qilinxiaoxiang/cmu-microduck/3-brain-and-senses/camera/CAMERA.md

# MicroDuck head camera stream (measured 2026-10-16, Pi Zero W, Camera Module 3 Wide)

- Pi side: `duck-cam.service` runs `pi/duck_cam.sh` (rpicam-vid, H.264 baseline 640x480 10 fps, TCP listener). Start/stop: `ssh duck sudo systemctl start|stop duck-cam.service`; disable on boot: `sudo systemctl disable --now duck-cam.service`; logs: `journalctl -u duck-cam.service -f`. A client disconnect ends rpicam-vid (SIGABRT "failed to send data on socket"); systemd restarts it within ~1 s. One client at a time.
- Stream URL: `tcp://<head-computer>:8554` (raw H.264 Annex B, SPS/PPS every 10th frame). Mac: `from duck_cam import DuckCam; cam = DuckCam().start(); frame, t_arrival, idx = cam.latest()`. CLI: `~/.venvs/microduck-walk/bin/python duck_cam.py --seconds 60 --save DIR --arrivals a.txt`.
- Sensor mode in use: 2304x1296 (full sensor, 2x2 binned; journal line "Selected sensor format: 2304x1296"). The 640x480 output is ScalerCrop (576,0)/3456x2592: full sensor height, centre 75 % of the width. FOV about 86 deg horizontal x 67 deg vertical (rectilinear estimate from the 102 x 67 deg full-sensor spec). `--no-raw` must stay out of the command: it overrides `--mode` and the sensor falls back to the cropped 1536x864 mode (2/3 FOV).
- Flicker: `--flicker-period 8333` (60 Hz mains) removed the pink/green banding seen in the uncorrected still; exposure then locks at 8310 us (metadata readback).
- Measured on the Mac over Tailscale (direct LAN path, `tailscale ping` 16 ms; Pi Wi-Fi power save already off, -52 dBm, TX 26 Mbit/s): open 1.55-2.07 s, first frame 3.1-4.5 s after `start()`. Clean 60 s run (no other ssh/CPU load): 599 frames, 9.99 fps, gap mean 100 ms, max 230 ms. Backlog probe (pause reader 1 s, drain): 9 frames drained in 92 ms vs 10 expected, i.e. about 0 frames in flight at steady state; decode on the Mac keeps up.
- Stalls under contention: a 40 s run while `top` was polled over ssh on the Pi fell to 8.1 fps with a 5.4 s gap; the first 60 s run (Mac busy with other scripts) had 14 gaps >200 ms, max 1.13 s. The IMU stream did not stall at those moments. A controller must use `t_arrival` and treat frames older than ~0.3 s as missing rather than acting on them.
- IMU impact (walk_wired log /tmp/duck_wired_log_1016y.jsonl, 60 s windows, mode stand): baseline p50 11.3 / p95 30.1 / max 68.5 ms, 0.87 % over 40 ms; streaming p50 11.7 / p95 27.8 / max 59.3 ms, 0.64 % over 40 ms. Pi CPU while streaming: rpicam-vid 11-18 %, IMU reader 24-35 % (top samples).
- MJPEG alternative (`DUCK_CAM_CODEC=mjpeg`): first frame 1.49 s (faster) but 7.3 fps and more bandwidth; backlog also ~0. H.264 kept.
- Orange detector (`orange_target.py`, HSV 5-22 / 120-255 / 120-255, open 5x5, largest component): 57/57 stream frames hit the orange printed part at cx 52.5 +/- 0.22 px, cy 459.3 +/- 0.09 px, area ~3074 px. Scene HSV (percentile 5/50/95): orange part H 7/10, S 236, V 150; red box label H 1-6, S 109 (mostly rejected); cardboard H 16-18, S 136-154, V 70-85 (rejected only by V < 120, the main false-positive risk under brighter light); white desk S ~20; grey floor H 30-50, S < 30.
- Known gaps: no clock-aligned end-to-end latency figure (Pi and Mac clocks differ; only backlog and first-frame times measured); one client only; stalls under Wi-Fi/CPU contention are not yet characterised with a dedicated test; the detector keys on a colour range, not an object model, so other saturated orange/red surfaces will be picked up.
