qilinxiaoxiang/cmu-microduck/2-servos-openrb/scripts/servo_ids.png

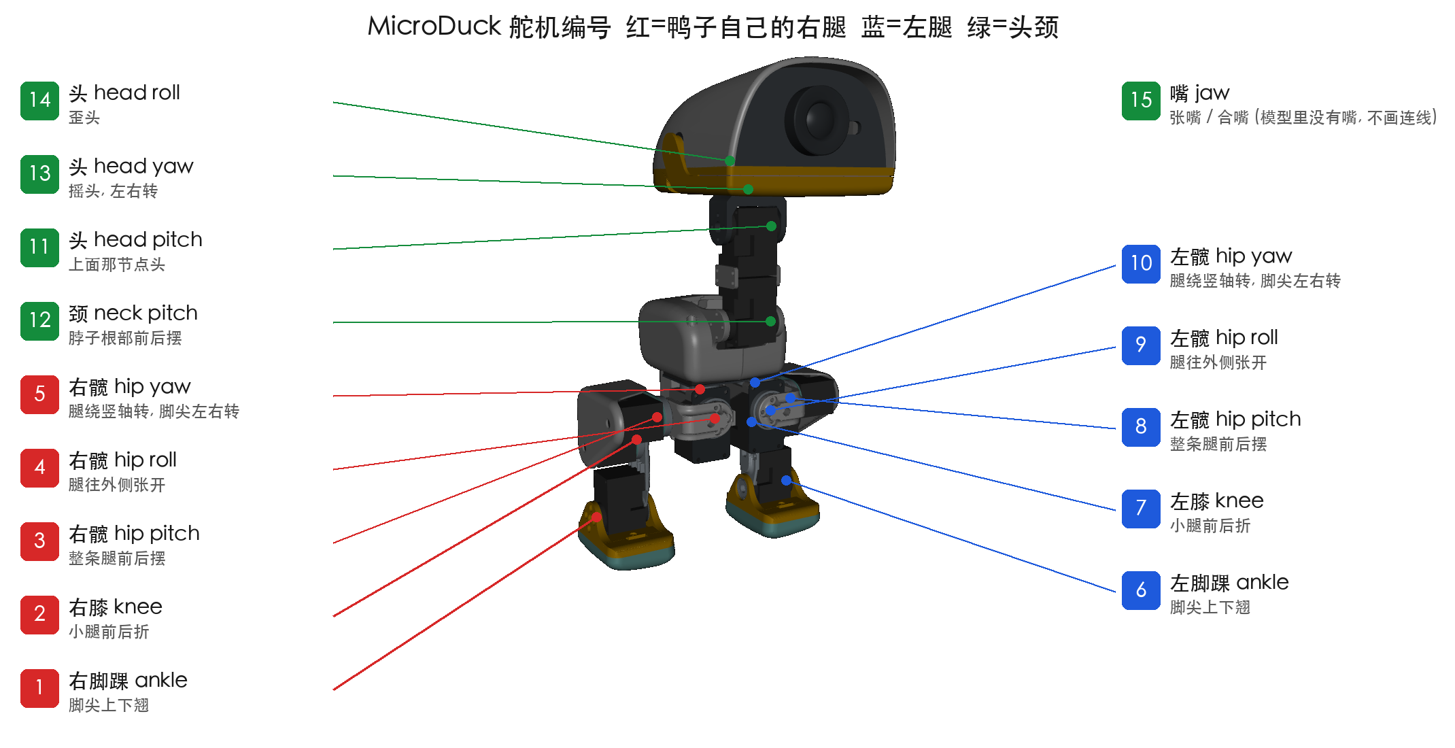
2-servos-openrb/scripts/servo_ids.png
