qilinxiaoxiang/cmu-microduck/3-brain-and-senses/touch/touch_layout.png

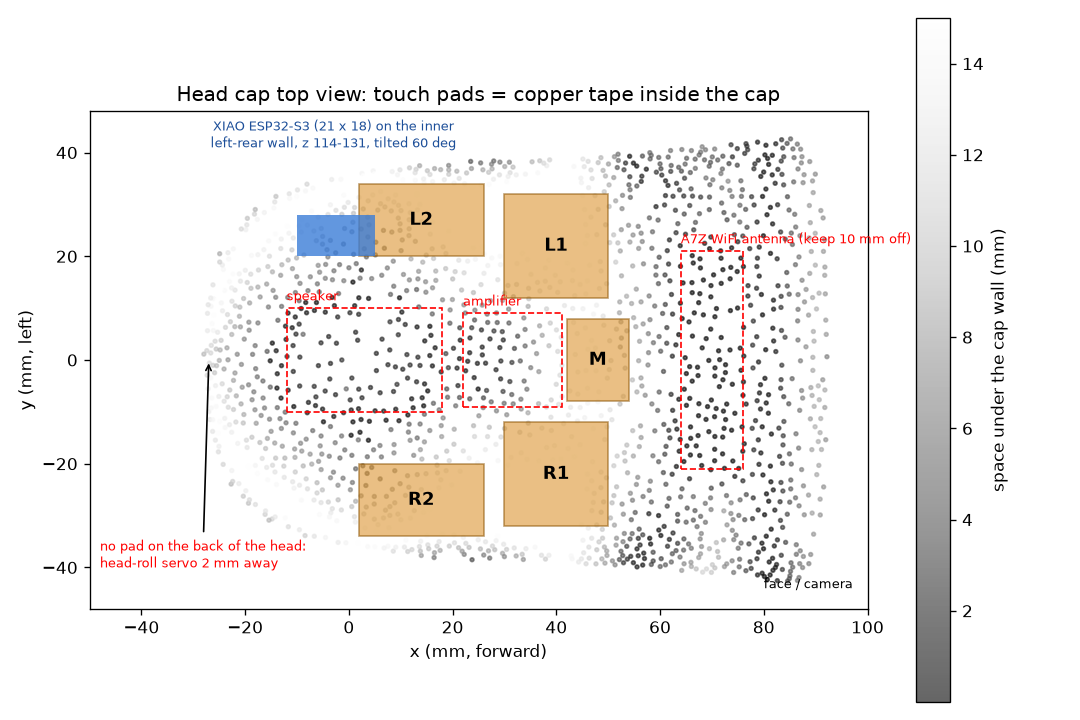
3-brain-and-senses/touch/touch_layout.png
