qilinxiaoxiang/cmu-microduck/4-power/images/amass_mr30_pair.jpg

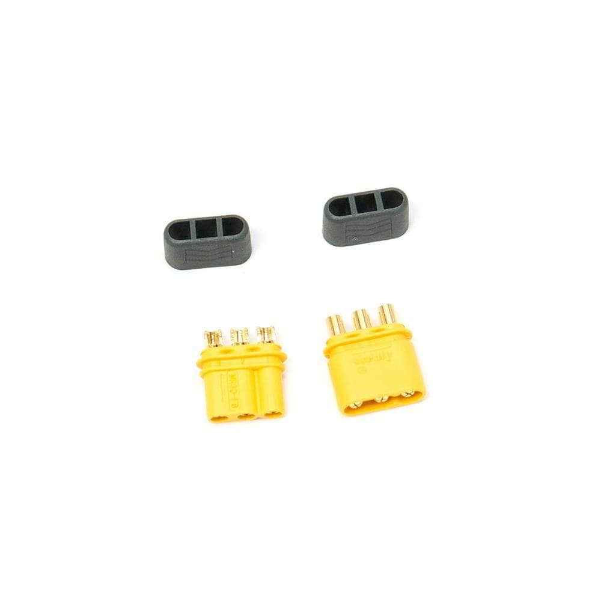
4-power/images/amass_mr30_pair.jpg
