qilinxiaoxiang/cmu-microduck/4-power/images/dfr1202_top.jpg

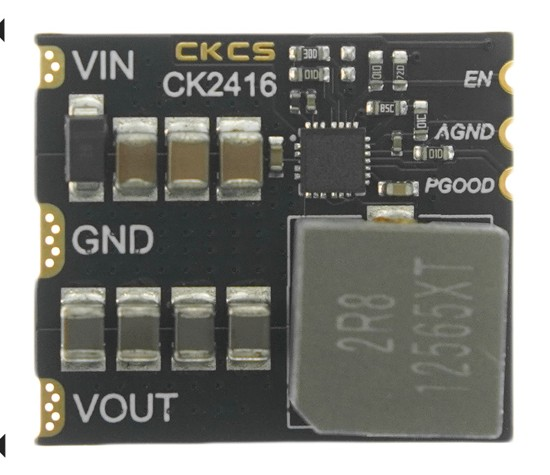
4-power/images/dfr1202_top.jpg
