qilinxiaoxiang/cmu-microduck/4-power/images/openrb_150_top.png

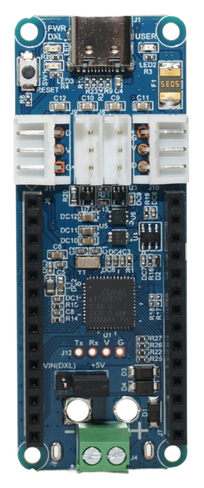
4-power/images/openrb_150_top.png
