qilinxiaoxiang/cmu-microduck/4-power/images/pd5991_board.jpg

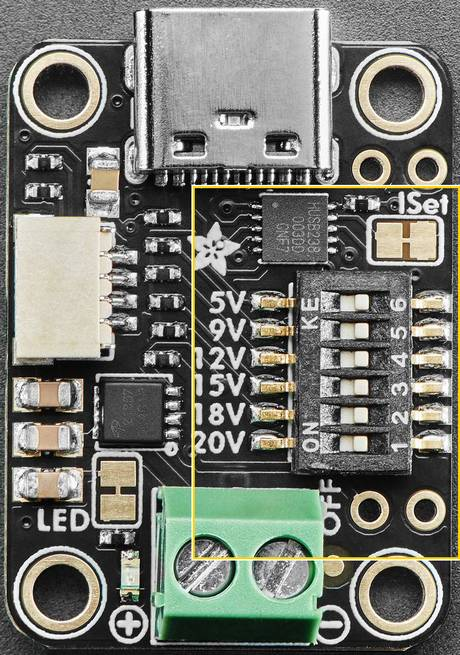
4-power/images/pd5991_board.jpg
