qilinxiaoxiang/cmu-microduck/4-power/images/pd5991_dip.jpg

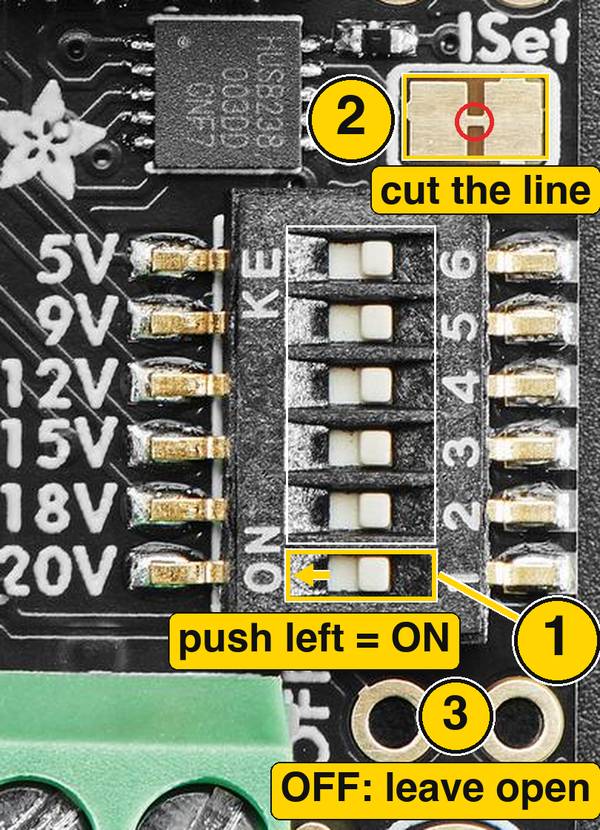
4-power/images/pd5991_dip.jpg
