qilinxiaoxiang/cmu-microduck/4-power/images/power-web.jpg

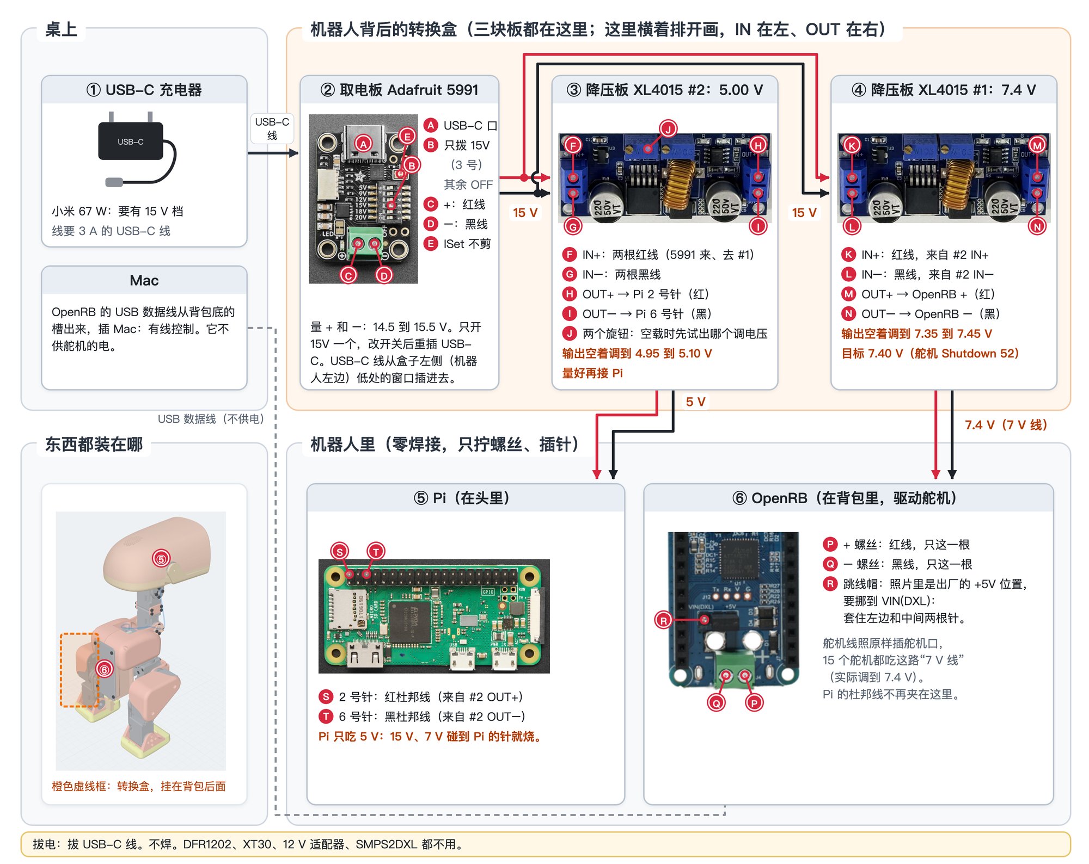
4-power/images/power-web.jpg
