qilinxiaoxiang/cmu-microduck/4-power/images/rev_31_1387.png

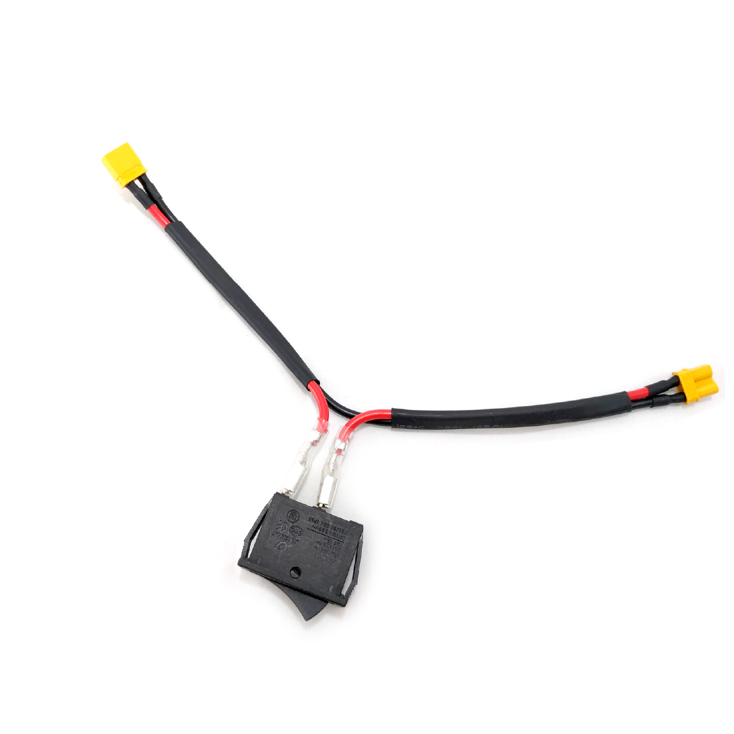
4-power/images/rev_31_1387.png
