qilinxiaoxiang/cmu-microduck/4-power/images/swann39_side.jpg

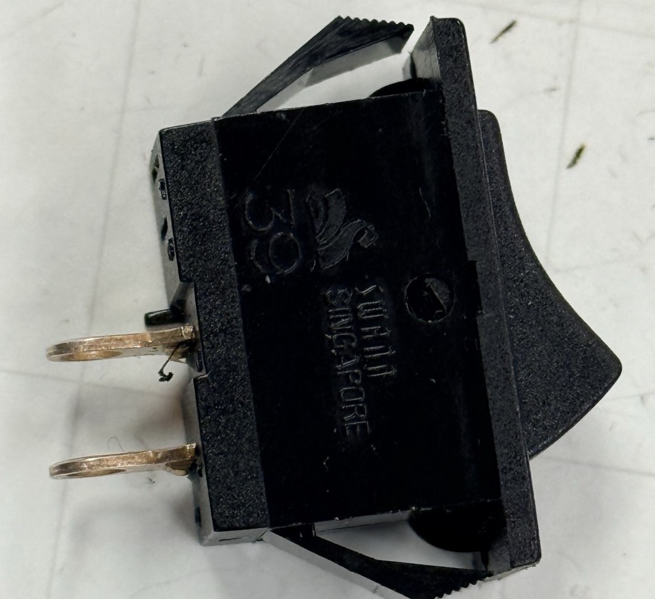
4-power/images/swann39_side.jpg
