qilinxiaoxiang/cmu-microduck/4-power/images/tattu_2s650_xt30.jpg

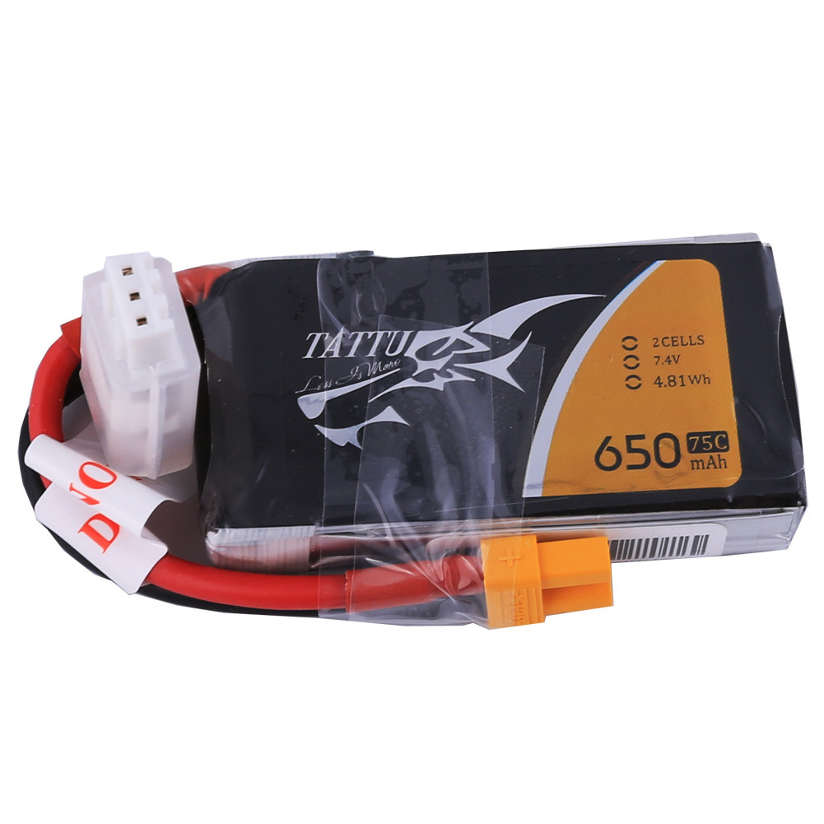
4-power/images/tattu_2s650_xt30.jpg
