qilinxiaoxiang/cmu-microduck/4-power/images/usb_pd_5991_top.jpg

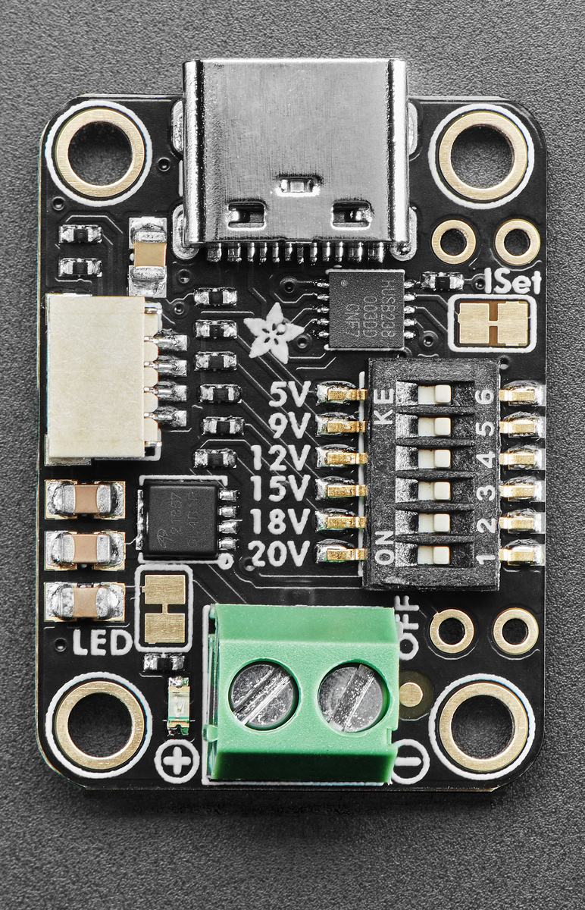
4-power/images/usb_pd_5991_top.jpg
