qilinxiaoxiang/cmu-microduck/4-power/images/xl4015_board.jpg

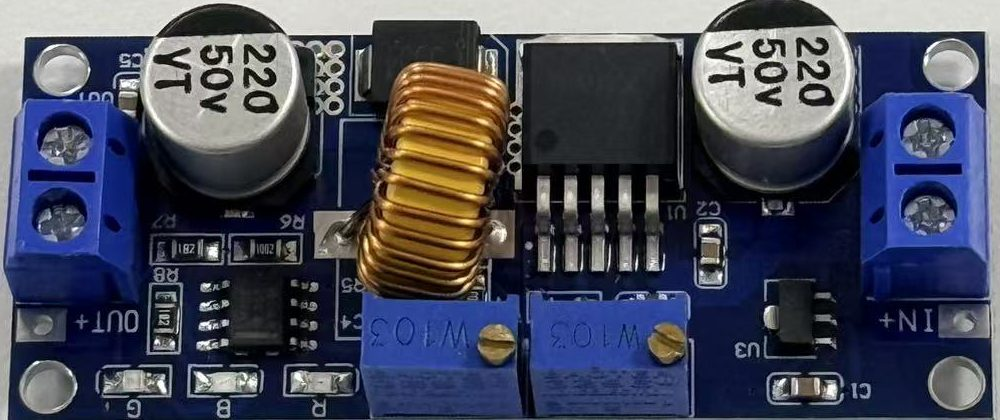
4-power/images/xl4015_board.jpg
