qilinxiaoxiang/cmu-microduck/4-power/images/xl4015_trimmers_annotated.png

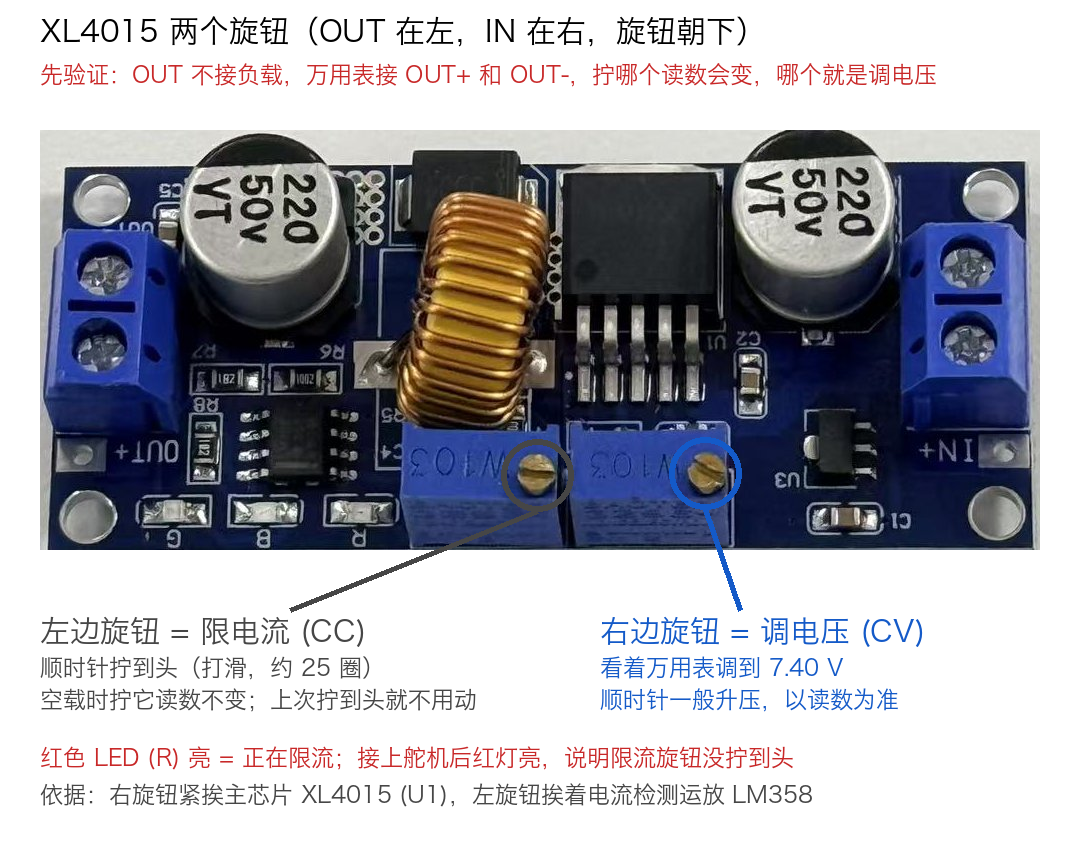
4-power/images/xl4015_trimmers_annotated.png
