qilinxiaoxiang/cmu-microduck/4-power/images/xt30_fit0586_rear.jpg

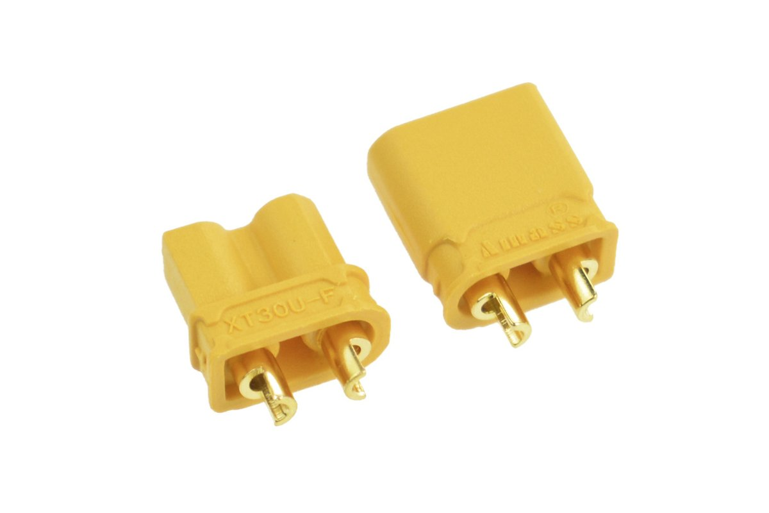
4-power/images/xt30_fit0586_rear.jpg
