qilinxiaoxiang/cmu-microduck/BOM.md

# Bill of materials, CMU MicroDuck foundation (2026-10-23)

Generated by `scripts/build_bom.py` from the project's procurement records (`bom.json`, `catalog-en.json`, `cart-plan.json`, `sourcing-policy.json`, prices as read on the dates recorded there, mostly September and October 2026) and `0-procurement/foundation-additions.json` for the parts bought after those records. Prices are what the records hold, not current quotes. Order numbers and receipts are not published. The sourcing policy of the project is kept: a part on hold or marked club supply was not bought, and this list does not ask you to buy it either; the CMU RoboClub drawers supplied screws, wire and consumables.

The role text of the club-drawer and tool rows is the September 2026 record and some of it describes the harness of that time (12 V, SMPS2DXL, Raspberry Pi); the part and quantity columns are what the robot uses. Printed parts are in `1-printing/`. Servo count, roles and IDs are in `2-servos-openrb/`.

## Bought or supplied for this robot and on it now

| Part | Qty | Store | Unit price | Link | Note |
|---|---|---|---|---|---|
| Radxa Cubie A7Z (Allwinner A733, 40-pin header) | 1 each | Amazon | not recorded |  | Head computer since 2026-10-17 (D-011). Ordered on Amazon 2026-10-15; the listing and price were not kept in the project records. Radxa product page: https://radxa.com/products/cubie/a7z |
| Adafruit 3006 MAX98357A I2S mono amplifier | 1 each | DigiKey | $5.95 | [link](https://www.digikey.com/en/products/detail/adafruit-industries-llc/3006/6058477) | Converts the Pi digital audio stream and drives the speaker. |
| Radxa AC019 dual-band FPC Wi-Fi antenna, IPEX gen 1, 42 x 11.9 mm | 1 each | with the A7Z | not recorded |  | Stuck under the front of the head cap crown (docs/A7Z-ANTENNA.html). |
| Discarded bicycle inner tube (butyl, about 1 mm) plus thin double-sided tape | 1 piece | free | included |  | Foot soles, cut with the template in the feet-sole study; the hot-glue mold route was dropped 2026-10-19. |
| ROBOTIS OpenRB-150 (included in OMX-AI) | 1 each | ROBOTIS US | $52.79 | [link](https://robotis.us/products/openrb-150-starter-kit) | One OpenRB-150 servo bus controller allocated from the two authorized OMX-AI kits. |
| Copper foil tape with conductive adhesive, 5 mm strips | 1 roll | Amazon | $5.95 |  | The five touch pads inside the head cap (L1, R1 18 mm; L2, R2, M 12 mm). Price from the touch plan (USD 5.95); listing not kept. |
| Adafruit BNO085 / 4754 | 1 each | DigiKey | $29.50 | [link](https://www.digikey.com/en/products/detail/adafruit-industries-llc/4754/13426653) | Measures body orientation from its fixed trunk mount. |
| Adafruit 4397 STEMMA QT/Qwiic JST-SH4 to female sockets, 150mm | 1 lead | DigiKey | $0.95 | [link](https://www.digikey.com/en/products/detail/adafruit-industries-llc/4397/10824270) | Connects to the Pi I2C bus. |
| ROBOTIS X3P180mm, JST EHR-3 / 21AWG | 15 lead | kit | included |  | Cut each in half to obtain 30 approximately 90mm tails. |
| ROBOTIS OMX-AI kit (two kits supply the 15 XL330-M288-T, the OpenRB-150, the X3P cables, the XL4015 modules and the TAP screws) | 2 kit | ROBOTIS US | not recorded | [link](https://robotis.us) | The servo and controller rows below are allocated from these kits; the kit price is not kept in the records. |
| Adafruit 5991 HUSB238 switchable USB PD receiver | 1 each | DigiKey | $9.95 | [link](https://www.digikey.com/en/products/detail/adafruit-industries-llc/5991/24892287) | Power route A: the HUSB238 decoy that asks the USB-C PD source for 20 V (D-007, D-014). The 'retired 2026-10-13' flag in the record is stale. |
| Four precrimped female 2.54mm leads, 22AWG, 250mm, fixed insulated housing | 4 each |  | not recorded |  | The two 5 V leads to A7Z header pins 2 and 6. |
| Radxa Camera 13M 214 (IMX214, 4-lane CSI) | 1 each | Amazon | not recorded |  | Eye camera on the A7Z CSI port, screwed to the V1.17 face panel bosses with four M2 x 4. Ordered on Amazon 2026-10-15; listing and price not kept. Radxa docs: https://docs.radxa.com/en/accessories/camera/camera-13m-214 |
| 32GB microSD; reuse or borrow a compatible card | 1 card | CanaKit | included | [link](https://www.canakit.com/raspberry-pi-zero-2-w.html?cid=usd) | The 16 GB microSD now carries the A7Z Debian image (3-brain-and-senses). |
| Adafruit5212 USB Type C microSD reader/writer | as needed each | Adafruit | $6.95 | [link](https://www.adafruit.com/product/5212) | Needed once to write the A7Z card. |
| ROBOTIS DYNAMIXEL XL330-M288-T / 902-0163-000 | 15 each | ROBOTIS US | $27.49 | [link](https://robotis.us/products/dynamixel-xl330-m288-t) | Fourteen walking/head-neck joints and the fifteenth servo for the jaw. |
| Same Sky CMS-30204-18SP, 8 ohm 1W oval speaker | 1 each | DigiKey | $1.34 | [link](https://www.digikey.com/en/products/detail/same-sky-formerly-cui-devices/CMS-30204-18SP/29778290) | The component that produces sound; neither Pi nor OpenRB includes this speaker. |
| Adafruit 4472 USB-A to USB-C data/sync cable, 6 inch | 1 lead | DigiKey | $2.95 | [link](https://www.digikey.com/en/products/detail/adafruit-industries-llc/4472/11587359) | Intact short data cable from the OTG adapter to OpenRB-150. |
| USB-C PD wall charger with a 20 V 5 A (100 W) PDO | 1 each | owned | not recorded |  | Power route A source. A 20 V 3 A (60 W) charger folds back at the walking current peaks and freezes the A7Z (2026-10-22). Model not recorded. |
| Seeed Studio XIAO ESP32-S3 | 1 each | Seeed Studio | $7.49 | [link](https://www.seeedstudio.com/XIAO-ESP32S3-p-5627.html) | Touch readout board in the head cap: five capacitive inputs, I2C slave at 0x2A to the A7Z (D-013). Price read 2026-10-15. |
| Xiaomi 212W HyperCharge Power Bank 25000 | 1 each | owned | not recorded | [link](https://www.mi.com/global/product/xiaomi-212w-hypercharge-power-bank-25000/) | Power route A source for untethered runs; the robot ran from it on 2026-10-23. |
| XL4015 CC/CV buck converter modules (two, from the ROBOTIS OMX-AI kits) | 2 each | ROBOTIS US (kit accessory) | included |  | #1 makes the servo rail, #2 the A7Z 5 V, both in the rear converter box (D-007). |

## Battery route (D-010): bought, backpack being built, not yet on the robot

| Part | Qty | Store | Unit price | Link | Note |
|---|---|---|---|---|---|
| Tattu 650 mAh 2S 7.4 V 75C LiPo, XT30 plug | 2 each | Amazon | $9.16 | [link](https://www.amazon.com/dp/B0727XZFDW) | Power route B (D-010). Bought 2026-10; backpack not yet on the robot. |
| Tenergy LiPo safety bag, medium 7 x 9 in | 1 each | Amazon | $8.99 | [link](https://www.amazon.com/dp/B08QCMMGJT) | Charging and storage bag for the two packs. |
| Amass MR30 male + female, 10 pairs | 1 pack | Amazon | $9.99 | [link](https://www.amazon.com/dp/B0747MW9RX) | The 5 V joint for the A7Z lead: a shape that cannot mate with the XT30 servo joint. |
| DFRobot FIT0586 XT30 male+female pair / DigiKey 1738-1436-ND | 1 pair | DigiKey | $1.90 | [link](https://www.digikey.com/en/products/detail/dfrobot/FIT0586/9559255) | XT30 pair: the robot's servo inlet for the battery backpack (D-010). |
| Swann 39 rocker switch (RoboClub drawer); D-010 planned the REV-31-1387 XT30 switch | 1 each | CMU RoboClub | not recorded |  | The V1.20 and V1.31 backpack frames carry the 12.3 x 27.5 mm cutout for the Swann 39 body. |
| DFRobot DFR1202, 6-24V input, 5V output | 1 each | DigiKey | $12.90 | [link](https://www.digikey.com/en/products/detail/dfrobot/DFR1202/27526972) | Power route B: makes 5 V for the A7Z inside the battery backpack (D-010). Bought; backpack not yet on the robot. |
| Amass XT30U male + female, 10 pairs with heat shrink | 1 pack | Amazon | $8.99 | [link](https://www.amazon.com/dp/B07CTRH86M) | Backpack feed lead (male) and servo lead (female); spares. |

## From the CMU RoboClub drawers (not bought; club supply)

| Part | Qty | Store | Unit price | Link | Note |
|---|---|---|---|---|---|
| Pyrodrone24AWG silicone wire,1m red+1m black | 0.25 m per color | Pyrodrone | $3.99 | [link](https://pyrodrone.com/products/1ft-silicone-wire-choose-color-and-gauge?variant=16927242911787) | Direct 24AWG power pair from the 0.5A fuse/common ground to amplifier VIN/GND. |
| Pyrodrone 20AWG Silicone Wire, 1m red + 1m black/set | 2.0 m per color | Pyrodrone | $5.99 | [link](https://pyrodrone.com/products/1ft-silicone-wire-choose-color-and-gauge?variant=16927272861739) | Eight motor group feeds, each250mm per color including20mm before the fuse. |
| Heat shrink for the two splices and the DATA wire end, three small cable ties, 12V polarity label | as needed set |  | not recorded |  | Insulates the SMPS2DXL cable splices and keeps tether pull off the solder joints and the SMPS2DXL plug. |
| Bambu PLA Basic Jade White 10100, 1.75mm, 1kg WITH SPOOL | as needed g | Bambu Lab US | $22.99 per pack of 1000 | [link](https://us.store.bambulab.com/products/pla-basic-filament) | Prints the original duck and all revised components. |
| Adafruit 3468 electronics flux | as needed each | Adafruit | $7.95 | [link](https://www.adafruit.com/product/3468) | Assists wire and small-pad wetting. |
| 3M (TC) 4492W-0.5-5 / 1067-4492W-0.5-5-ND, 1/2 inch × 5 yards, 0.787mm nominal | as needed roll | DigiKey | $11.93 | [link](https://www.digikey.com/en/products/detail/3m-tc/4492W-0-5-5/2649500) | Audio support height adjustment and battery cushioning. |
| Adafruit 4559 heat-shrink assortment | as needed set | Adafruit | $9.95 | [link](https://www.adafruit.com/product/4559) | Separately insulates fuses and main/data solder joints. |
| M2.6x6 TAP; manufacturer-matched rear-center screw; ROBOTIS BHS rounded head profile, diameter5.5mm height1.565mm | 8 screw | ROBOTIS US | $11.27 per pack of 8 | [link](https://www.robotis.us/fpx330-h101-4pcs-set/) | Six integral rear supports plus two standalone idler/cap assemblies at IDs11 and12. |
| Adafruit 3057 polyimide tape | as needed roll | Adafruit | $4.95 | [link](https://www.adafruit.com/product/3057) | Insulates bare connectors; cannot substitute for structural ties. |
| M2-0.4x10mm pan-head screw; head <=4mm diameter x1.72mm height | 4 each |  | not recorded |  | Camera PCB to cradle; full M2 nut engagement and 1.73mm tip extension. |
| M2-0.4×12mm A2 Phillips pan, DIN7985A/ISO7045 | as needed each | Monster Bolts | $1.14 per pack of 10 | [link](https://monsterbolts.com/products/mach-phil-pan-a2-m2?variant=38436355020) | Unused old small-regulator cover; no small regulator in current design. Cover screws interfere with retained motors. |
| M2-0.4×18mm A2 Phillips pan, DIN7985A/ISO7045 | 4 each | Monster Bolts | $1.46 per pack of 10 | [link](https://monsterbolts.com/products/mach-phil-pan-a2-m2?variant=38436768844) | Four OpenRB standoffs. |
| M2-0.4×20mm A2 Phillips pan, DIN7985A/ISO7045 | 4 each | Monster Bolts | $1.37 per pack of 10 | [link](https://monsterbolts.com/products/mach-phil-pan-a2-m2?variant=38436355596) | Four fuse-carrier screws through11.5mm carrier posts and4mm shelf/boss stack, without old regulator PCB; retain four nuts. |
| Uxcell a16110800ux1019 M2-0.4×25mm 304 Phillips pan,25 sets | 2 each | Harfington | $9.07 per pack of 25 | [link](https://www.harfington.com/products/p-1098147?variant=42122298130681) | Two long audio-carrier standoffs. |
| M2-0.4×5mm A2 Phillips pan, DIN7985A/ISO7045 | 2 each | Monster Bolts | $1.04 per pack of 10 | [link](https://monsterbolts.com/products/mach-phil-pan-a2-m2?variant=38436353164) | Two IMU clamp screws. |
| M2-0.4x6mm pan-head screw; head <=4mm diameter x1.72mm height | 4 each |  | not recorded |  | IMU rear cover alone into four existing 1.6mm pilot holes; 4.8mm engagement. |
| M2-0.4×8mm A2 Phillips pan, DIN7985A/ISO7045 | as needed each | Monster Bolts | $1.07 per pack of 10 | [link](https://monsterbolts.com/products/mach-phil-pan-a2-m2?variant=38436354188) | Superseded: camera now M2x10 for full nut engagement; rear cover alone now M2x6. |
| M2-0.4 A2 DIN934 | 14 each |  | included |  | Four OpenRB, two audio, four camera and four fuse-carrier nuts. |
| M3-0.5×10mm socket button head ISO7380 | 2 each | Monster Bolts | $1.43 per pack of 10 | [link](https://monsterbolts.com/products/socket-button-b12-9-m3?variant=35216415564) | Camera base. |
| M3-0.5×20mm socket button head ISO7380 | 1 each | Monster Bolts | $1.57 per pack of 10 | [link](https://monsterbolts.com/products/socket-button-b12-9-m3?variant=35216416332) | Camera tilt axle. |
| M3-0.5 A2 DIN934 | 3 each | Monster Bolts | $0.65 per pack of 10 | [link](https://monsterbolts.com/products/nuts-din934-a2?variant=40341941715027) | Two camera-base nuts and one tilt-axis nut. |
| M3 DIN125A, ID3.2×OD7×thickness0.5mm | 4 each | Monster Bolts | $0.59 per pack of 10 | [link](https://monsterbolts.com/products/washers-din125a-a2?variant=31351045652563) | Two base washers and two tilt-axis washers. |
| OutOfDarts 16AWG tinned-copper silicone wire, red+black pair by foot | 0.3 m per color | OutOfDarts | $1.29 per pack of 0.3048 | [link](https://outofdarts.com/products/silicone-stranded-hobby-wire-red-black-pair?variant=14314617634858) | Short onboard 5V main and star distribution. |
| 18AWG flexible stranded copper, red+black, 2m operating run | 2 m per color |  | not recorded |  | Carries 12 V (about 1.1 A walking, about 2.7 A in 20 ms peaks) from the SMPS2DXL cable splices to the robot XT30, so the long wire never carries 5 V motor current. |
| Eight compatible precrimp signal tails plus ordinary insulated 26AWG DATA extension wire | 8 precrimp lead | Adafruit | $1.95 per pack of 20 | [link](https://www.adafruit.com/product/1950) | Four audio signal/reference-ground tails, four IMU extension tails and one extended motor DATA link. |
| Adafruit145,60/40 no-clean rosin core0.3mm,100g | as needed roll | Adafruit | $14.95 | [link](https://www.adafruit.com/product/145) | Joins harness wires and axial fuses. |
| M2.5x8 TAP; head <=4mm diameter x1.5mm height | 3 each |  | not recorded |  | Head-cap closure C1,C2,C3 into matching 2.1mm pilots, no nuts. |
| M2.6x8 TAP; manufacturer-matched rear-center thread; ROBOTIS BHS rounded head profile, diameter5.5mm height1.565mm | 2 each |  | not recorded |  | Ankle IDs1 and6 rear centers, each with one specified 0.5mm washer. |
| M2x10 TAP; head <=4mm diameter x1.72mm height | 18 each |  | not recorded |  | Joint output or case attachment; exact motor face and hole shown in motor-fastener-locations.png. |
| M2x4 TAP; head <=4mm diameter x1.72mm height | 8 each |  | not recorded |  | Joint output or case attachment; exact motor face and hole shown in motor-fastener-locations.png. |
| M2x5 TAP; head <=4mm diameter x1.72mm height | 12 each |  | not recorded |  | Joint output or case attachment; exact motor face and hole shown in motor-fastener-locations.png. |
| M2x6 TAP; head <=4mm diameter x1.72mm height | 46 each |  | not recorded |  | Joint output or case attachment; exact motor face and hole shown in motor-fastener-locations.png. |
| M2x7 TAP; head <=4mm diameter x1.72mm height | 2 each |  | not recorded |  | Joint output or case attachment; exact motor face and hole shown in motor-fastener-locations.png. |
| M2x8 TAP; head <=4mm diameter x1.72mm height | 22 each |  | not recorded |  | Joint output or case attachment; exact motor face and hole shown in motor-fastener-locations.png. |
| Panduit PLT2M-C / 298-1028-ND, nominal 203×2.5×1.1mm | 4 each | DigiKey | $0.29 | [link](https://www.digikey.com/en/products/detail/panduit-corp/PLT2M-C/280041) | Four fuse-carrier retaining rings. |
| Panduit PLT.6SM-C / 298-1016-ND, nominal 71×1.8×0.8mm | 12 each | DigiKey | $0.20 | [link](https://www.digikey.com/en/products/detail/panduit-corp/PLT-6SM-C/280029) | Audio rings, two converter edge restraints, and two USB/harness strain-relief points. |
| Panduit PLT3S-C / 298-1033-ND, nominal 292×4.8×1.3mm | 2 each | DigiKey | $0.63 | [link](https://www.digikey.com/en/products/detail/panduit-corp/PLT3S-C/280046) | Two 4.8mm straps retain the new converter insert in the old battery guide. |
| DIN433 / ISO7092 M2.5 metal washer: ID2.7mm OD5.0mm thickness0.5mm | 4 each |  | not recorded |  | One under each rear-center screw head at motor IDs1,4,6,9. |
| Chip Quik SOLDERWICK1.5 / 315-SOLDERWICK1.5-ND, 1.5mm × 1.524m | as needed each | DigiKey | $2.59 | [link](https://www.digikey.com/en/products/detail/chip-quik-inc/SOLDERWICK1-5/14636565) | Desoldering braid for repairing solder bridges and poor joints. |

## Tools and bench equipment (borrowed, not bought)

| Part | Qty | Store | Unit price | Link | Note |
|---|---|---|---|---|---|
| adjustable0–12V DC,≥10A,variable current limit | as needed set |  | not recorded |  | Powers the first individual groups under a current limit; borrow if possible. |
| 0.1mm or better resolution | as needed set |  | not recorded |  | Measures battery, connectors, holes and screws. |
| User computer with Wi-Fi,USB-C and SD reader path | as needed set |  | not recorded |  | Remote control, video reception and heavier vision processing. |
| local solder fume extraction | as needed set |  | not recorded |  | Removes solder fumes locally. |
| deburring tool,small file,pliers;eye protection | as needed set |  | not recorded |  | Removes supports and cleans holes without damaging load-bearing faces. |
| heat gun with temperature control | as needed set |  | not recorded |  | Shrinks insulating tubing. |
| continuity/DC volts,resistance | as needed set |  | not recorded |  | Checks continuity, polarity and unloaded 5V outputs. |
| 2.4GHz Wi-Fi router/AP or compatible computer hotspot | as needed set |  | not recorded |  | Mac-to-Pi network transport requires exact-board confirmation; do not assume the borrowed first-generation Zero includes wireless. |
| Multimeter, electronic load >=60W, oscilloscope and temperature probe | as needed set |  | not recorded |  | Verify 11.5-12.5 V at the XT30, voltage drop under load, thermal load and startup/stop transients. |
| RoboClub Bambu Lab X1 Carbon,0.4mm nozzle | as needed set |  | not recorded |  | Prints the verified project configuration; availability/reservation unconfirmed. |
| 0.1g resolution | as needed set |  | not recorded |  | Measures complete onboard mass and trimmed connectors/harness. |
| Phillips #0/#1;2mm hex key;4mm M2 nut driver;5.5mm M3 nut driver | as needed set |  | not recorded |  | Installs servo tapping screws and M2/M3 hardware. |
| temperature-controlled iron+stand;fine/chisel tips | as needed set |  | not recorded |  | Confirm or borrow before harness fabrication; no special crimp machine required. |
| Colored heat-shrink plus fine permanent marker | as needed pack |  | not recorded |  | Mark all fifteen IDs, eight fused groups and polarity. |
| 16–28AWG wire stripper,flush cutter,tweezers | as needed set |  | not recorded |  | Handles 16/20/21AWG wiring and JST terminal removal. |

## Bought earlier, replaced before the foundation

| Part | Qty | Store | Unit price | Link | Note |
|---|---|---|---|---|---|
| Raspberry Pi SC1224 Camera Module 3 Wide, visible-light IR-filter IMX708 | 1 each | DigiKey | $35.00 | [link](https://www.digikey.com/en/products/detail/raspberry-pi/SC1224/17278644) | Camera Module 3 Wide was the Pi-era eye camera; replaced by the Radxa Camera 13M 214 on the A7Z CSI port (D-011). |
| Raspberry Pi SC1892 200mm camera FFC, 15-pin to 22-pin | 1 lead | DigiKey | $1.00 | [link](https://www.digikey.com/en/products/detail/raspberry-pi/SC1892/21658272) | Pi camera ribbon; the Radxa camera comes with its own CSI cable. |
| Xiaomi MDY-14-ED | as needed each |  | not recorded |  | Xiaomi 67 W charger of the 15 V era. The foundation runs from a 20 V 5 A USB-C PD charger or the Xiaomi 212W power bank (CURRENT-STATE power). |
| First-generation Raspberry Pi Zero W with soldered 40-pin header; alternative Pi 3 Model B V1.2 | 1 each | CanaKit | $89.95 | [link](https://www.canakit.com/raspberry-pi-zero-2-w.html?cid=usd) | Raspberry Pi Zero W head board until 2026-10-17; replaced by the Radxa Cubie A7Z (D-011). Not on the robot. |

## Bought or supplied earlier, not on the foundation robot

| Part | Qty | Store | Unit price | Link | Note |
|---|---|---|---|---|---|
| Littelfuse 0251.500MXL,0.5A axial / DigiKey F2311-ND | 1 each | DigiKey | $1.37 | [link](https://www.digikey.com/en/products/detail/littelfuse-inc/0251-500MXL/700707) | Same as main_fuse. |
| YAGEO MFR-25FBF52-100K,100kΩ±1%,0.25W axial / DigiKey100KXBK-ND | 1 each | DigiKey | $0.10 | [link](https://www.digikey.com/en/products/detail/yageo/MFR-25FBF52-100K/13473) | The MAX98357A GAIN and SD pads are left open; the volume ceiling is the -3 dB ALSA softvol (D-012). |
| Compatible 5V MicroUSB bench supply; borrow or reuse | as needed each | CanaKit | included | [link](https://www.canakit.com/raspberry-pi-zero-2-w.html?cid=usd) | Pi-era bench supply. |
| Littelfuse 0251003.MXL, 3A axial / DigiKey F2315-ND | 9 each | DigiKey | $1.02 | [link](https://www.digikey.com/en/products/detail/littelfuse-inc/0251003-MXL/700737) | Same as main_fuse. |
| Littelfuse 0251005.MXL 5A axial / DigiKey F2317-ND | 1 each | DigiKey | $1.24 | [link](https://www.digikey.com/en/products/detail/littelfuse-inc/0251005-MXL/700749) | Same as main_fuse. |
| Littelfuse 0251010.MXL, 10A axial / DigiKey F2320-ND | 1 each | DigiKey | $1.24 | [link](https://www.digikey.com/en/products/detail/littelfuse-inc/0251010-MXL/700757) | Bought for an earlier harness; the foundation harness carries no fuses (D-013). |
| One non-stacking insulated 2x20 female housing for 2.54mm pitch and 12 matched contacts | 1 each |  | not recorded |  | Pi-era idea; every head wire is a single Dupont plug on the A7Z header. |
| Harfington/Uxcell a16060200ux0367,M2.5×6mm stainless Phillips pan self-tapping,100pcs | 8 each | Harfington | $9.11 per pack of 100 | [link](https://www.harfington.com/products/p-1033403?variant=42182571000057) | Pi Zero W mount; the A7Z sits on the head cap rails with M2.6 x 6 (see the build guide). |
| Adafruit 1826 USB DIY Slim MicroB plug | as needed each | DigiKey | $0.95 | [link](https://www.digikey.com/en/products/detail/adafruit-industries-llc/1826/5629443) | Pi Zero W accessory. |
| ROBOTIS SMPS 12V 5A (PS-10) with AC cord, OMX-AI kit accessory | as needed each |  | not recorded |  | Kit accessory, not in either power route. |
| ROBOTIS SMPS2Dynamixel (SMPS2DXL), SKU 902-0034-000, OMX-AI kit accessory | as needed each |  | not recorded |  | Kit accessory, not in either power route. |
| ROBOTIS 3-wire cable plugged into the SMPS2DXL, OMX-AI kit accessory | as needed lead |  | not recorded |  | Kit accessory, not in either power route. |
| Raspberry Pi SC0727 Micro-B OTG male to USB-A female finished adapter | 1 lead | DigiKey | $1.54 | [link](https://www.digikey.com/en/products/detail/raspberry-pi/SC0727/15298144) | Pi Zero W accessory. |

## Not bought: sourcing-policy hold, optional, or not needed by the current design

| Part | Qty | Store | Unit price | Link | Note |
|---|---|---|---|---|---|
| Adafruit 1131 JST-PH compatible 2-pin extension, 500mm/26AWG | as needed pair | DigiKey | $1.95 | [link](https://www.digikey.com/en/products/detail/adafruit-industries-llc/1131/5761282) | Disconnects head audio power. |
| Buddy RC 8-inch 2S JST-XH, 3 pins, silicone wire | 1 lead | Buddy RC | $1.50 | [link](https://www.buddyrc.com/products/8-2s-jst-xh-balance-extension-cable) | One onboard alarm lead and one charging-bench extension. |
| Gens ace GEA8502S60E2, 850mAh 2S 60C EC2 | 1 each | Gens ace / Tattu US | $17.99 | [link](https://www.genstattu.com/gens-ace-850mah-2s-60c-7-4v-lipo-battery-ec2-plug-car-classic-non-g-tech/) | Two-series-cell LiPo, 7.4V nominal and 8.4V fully charged. |
| HOTA T6 | as needed each | RaceDayQuads | $44.49 | [link](https://www.racedayquads.com/products/hota-t6-pd-15a-1-6s-ac-dc-smart-charger?variant=41289248276593) | Charges the detached 850mAh 2S pack at 0.8A. |
| Raspberry Pi 45W USB-C US / SC1731 / Adafruit6320 | as needed each | Adafruit | $16.50 | [link](https://www.adafruit.com/product/6320) | Provides 20V USB-PD input to HOTA T6. |
| Gens ace GEAX6F2E2M XT60 female → EC2 male | 1 lead | Gens ace / Tattu US | $3.99 | [link](https://www.genstattu.com/gens-ace-xt60-female-to-ec2-charging-cable/) | One trimmed onboard adapter and one intact charger adapter. |
| Pololu 1408 Mini Slide Switch 3-pin SPDT, 3-pack | 1 each | Pololu | $2.37 per pack of 3 | [link](https://www.pololu.com/product/1408) | Grounds the large regulator ENA pin to disable servo power. |
| ROBOTIS M2×6 TAP | as needed each | kit | included |  | Original servo/plastic mounting. |
| ROBOTIS M2×8 TAP | as needed each | kit | included |  | Original servo/plastic mounting. |
| OutOfDarts LiPo Charging Bag / Misprinted Logo variant44666207371306 | as needed each | OutOfDarts | $4.99 | [link](https://outofdarts.com/products/lipo-charging-bag-fireproof-battery-safety-storage?variant=44666207371306) | Contains the detached battery on a nonflammable bench while charging or transporting. |
| Pololu 4082 S13V30F5, fixed 5V | 1 each | Pololu | $17.95 | [link](https://www.pololu.com/product/4082) | Separately powers Pi, OpenRB logic and audio. |
| USB-C to Micro-B cable with 20AWG power pair; prepared length at most 500mm | as needed each |  | not recorded |  | Legacy separate-bank Pi cable; not required by the shared source. |
| HobbyKing DL-Volt-Alarm 2S–4S | 1 each | HobbyKing | $2.00 | [link](https://hobbyking.com/en_us/hobbykingtm-lipoly-low-voltage-alarm-2s-4s.html?___from_store=en_us) | Audibly requests stopping near 3.3V per cell. |
| Mean Well GST60A05-P1J / DigiKey1866-2146-ND | as needed each | DigiKey | $19.40 | [link](https://www.digikey.com/en/products/detail/mean-well-usa-inc/GST60A05-P1J/7703709) | Phase1 external tethered motor power chain. |
| Intact US NEMA 5-15P to IEC C13 grounded AC cord | as needed each |  | not recorded |  | Legacy AC cord; not required by the shared power bank. |
| Pololu 5671 D42V110F5, fixed 5V | 1 each | Pololu | $59.95 | [link](https://www.pololu.com/product/5671) | Supplies 5V to all 15 servos, each rated for 3.7-6V. |
| Tensility10-06257 / DigiKey839-10-06257-ND | as needed each | DigiKey | $10.64 | [link](https://www.digikey.com/en/products/detail/tensility-international-corp/10-06257/27685456) | Phase1 external tethered motor power chain. |
| 4 integral printed standoffs,height2mm | as needed each | kit | included |  | Separate the board from the carrier and solder joints. |
| ROBOTIS X3P 180mm 10pcs / 903-0249-000 | as needed lead | ROBOTIS US | $21.85 per pack of 10 | [link](https://robotis.us/products/robot-cable-x3p-180mm-10pcs) | Optional spare tails for cutting mistakes or longer local routes. |
| Xiaomi original modified USB-A male to USB-C male charger cable | as needed lead |  | not recorded |  | No robot role since 2026-10-13. It connected the MDY-14-ED to the Adafruit 5991 in the r3 chain. |
