qilinxiaoxiang/cmu-microduck/1-printing/PARTS.md

# Printed parts of the foundation robot (2026-10-23)

Generated by `scripts/collect_printed_parts.py` from the release records; do not edit by hand. Two sources make the body: the community print set from AI-FanGe's Microduck build tutorial (`community/microduck-community-print-set.3mf`, MIT, commit 4967821), printed on 2026-10-01 as 89 instances, and our incremental releases V1.6 to V1.31 that replaced or added parts. Releases applied, in order: V1.6, V1.7, V1.8, V1.9, V1.17, V1.20, V1.21, V1.22, V1.24, V1.25, V1.28, V1.31. Later releases (V1.29 saddle, V1.30 USB camera face) are extensions and are not here.

Colour scheme C: white shells, thighs and head cap; yellow lower head shell, jaw and feet; orange rear pack, converter box, backpack and ankles; black links, rings, trim and small parts. Material PLA, 0.4 mm nozzle, 0.2 mm layers; print on a Bambu X1C or an Elegoo Centauri Carbon (the per-colour plate files are listed in PLATES.md). Supports: tree supports from the slicer profile where the pose notes say so; brims per part as in PRINT-LESSONS.md.

## Our parts, by colour

Each entry: name, STL in this folder, quantity, release that introduced the geometry, print status on 2026-10-23, then the print pose and the reason for the part. STLs under `stl/our-parts/` are in print pose unless the entry says otherwise.

### White (6 parts)

- **Face panel for the Radxa Camera 13M 214 (A7Z head)** (`stl/our-parts/White/face_panel_a7z.stl`), x1, V1.17, printed. Size 87.7 x 44.6 x 3.6 mm.
  Pose: V1.8 face pose, front on the bed and bosses up: release-V1.8/manifest-V1.8.json face_panel.sourceToPrint applied to the robot-frame face (scripts/pose-sources-a7z.json); the result equals face-a7z/face_panel_a7z-print.stl to 2e-6 mm. File frame: print pose (bed at z 0), rotated here with the release sourceToPrint matrix.
  Why: A7Z face (face-a7z/README.md, checks.json): the V1.8 face with the Camera Module 3 bearing lands and two locating pegs removed from its back (75.8 mm3) and four round bosses added (dia 4.8, 2.3 mm tall, blind dia 1.7 pilots that stop 1.2 mm behind the front) under the corner holes of the Radxa Camera 13M 214, which screws on with 4 x M2 x 4.
  sha256 fc236c27ad3f378c2bd7d5ba690877ae2beb5ee148b38194c4e045a5bce6c3ad
- **Head cap for the Radxa Cubie A7Z** (`stl/our-parts/White/head_cap_a7z.stl`), x1, V1.17, printed. Size 126.5 x 91.6 x 47.1 mm.
  Pose: V1.9 cap pose (roof on the bed), release-V1.9/manifest-V1.9.json head_cap_v19.sourceToPrint (scripts/pose-sources-a7z.json): the A7Z cap is the V1.9 cap with material removed inside only, so the crown strip, 104.4 mm2 true contact and the ... File frame: print pose (bed at z 0), rotated here with the release sourceToPrint matrix.
  Why: A7Z head cap (a7z-head/build_a7z_head.py, checks.json): the V1.9 cap for the Radxa Cubie A7Z, which has the Pi Zero outline and hole pattern but carries the camera FPC connector and the microSD socket on its underside right where the V1.9 rails touch the board.
  sha256 a6551dfb4f75750e11c39905f4137e98960e12eec4a7aaaac18079030ba451aa
- **Left torso shell, screwed to the pack** (`stl/our-parts/White/shell_left_v20.stl`), x1, V1.17, printed. Size 41.7 x 80.9 x 34.0 mm.
  Pose: The 10/1 print pose of community-8.stl (rigid registration of the printed shell, residual under 0.00001 mm; scripts/pose-sources.json) turned 1.99 deg so the flat outer side face (753.5 mm2 facet) lies on the bed: the 10/1 left shell stood ... File frame: print pose (bed at z 0), rotated here with the release sourceToPrint matrix.
  Why: V2.0 side shell (print/v20-source/README.md, the builder 2026-10-13): one M2 x 6 straight down through the roof (dia 2.2 hole, dia 4.4 counterbore, floor 1.0 mm below the rim) into the V1.9 pack shoulder bar at x -21.5, y +20, replacing the rear cross screw that had to be driven 27 mm down a hand-drilled tunnel; the cross tunnel at x -38, z 35 is filled flush (360.6 mm3); S12-horn-029..032 get dia 4.4 ...
  sha256 7f045af5c0a88a2c140c45c564b5d06c32044ff2a87c3d137f365058e65934c0
- **Right torso shell, screwed to the pack** (`stl/our-parts/White/shell_right_v20.stl`), x1, V1.17, printed. Size 42.4 x 80.5 x 32.0 mm.
  Pose: The 10/1 print pose of community-10.stl (rigid registration of the printed shell, residual under 0.00001 mm; scripts/pose-sources.json) turned 0.036 deg so the flat outer side face (788 mm2 facet) lies exactly on the bed: 1228 mm2 true ... File frame: print pose (bed at z 0), rotated here with the release sourceToPrint matrix.
  Why: V2.0 side shell (print/v20-source/README.md, the builder 2026-10-13): one M2 x 6 straight down through the roof (dia 2.2 hole, dia 4.4 counterbore, floor 1.0 mm below the rim) into the V1.9 pack shoulder bar at x -21.5, y -20, replacing the rear cross screw that had to be driven 27 mm down a hand-drilled tunnel; the cross tunnel at x -38, z 35 is filled flush (276.6 mm3); S12-horn-026..028 get dia 4.4 ...
  sha256 0e2fa89f05ae0da5ad52274cf088bef4b634e91bc1422f78b534c8598de8f52a
- **Left thigh body (community part reprinted in white)** (`stl/our-parts/White/thigh_left.stl`), x1, V1.17, printed. Size 61.0 x 47.7 x 28.0 mm.
  Pose: 10/1 pose, flat, 28.0 mm tall, 1368.8 mm2 contact, tip angle 59.1 deg. File frame: print pose (bed at z 0), rotated here with the release sourceToPrint matrix.
  Why: Colour only: the stock 10/1 thigh geometry reprinted in white for colour scheme C; geometry unchanged.
  sha256 28703b0a2c59259cb64cafa481676fd7187b5765115b90c4bc0ccacf00ab0e25
- **Right thigh body (community part reprinted in white)** (`stl/our-parts/White/thigh_right.stl`), x1, V1.17, printed. Size 61.0 x 47.7 x 28.0 mm.
  Pose: 10/1 pose, as thigh_left (orientation-decision.json). File frame: print pose (bed at z 0), rotated here with the release sourceToPrint matrix.
  Why: Colour only: the stock 10/1 thigh geometry reprinted in white for colour scheme C; geometry unchanged.
  sha256 37359b9658cd59da2451d0669ba5f2d7789c8a48e0150a66c4901943e417da28

### Yellow (4 parts)

- **Left foot, slip fit on the ankle** (`stl/our-parts/Yellow/foot_left_slipfit.stl`), x3, V1.22, printed. Size 54.0 x 41.2 x 18.4 mm.
  Pose: The stock community-44.stl pose: flat sole on the bed, as the printed feet were made. File frame: print pose (bed at z 0).
  Why: Replaces the printed community-44.stl (stock object 32, the left foot).
  sha256 210c953abf325113dcaa47a7967a847f4ea5766c3cae2fcd571b7a7ca0773045
- **Right foot, slip fit on the ankle** (`stl/our-parts/Yellow/foot_right_slipfit.stl`), x3, V1.22, printed. Size 54.0 x 41.2 x 18.4 mm.
  Pose: The stock community-46.stl pose: flat sole on the bed, as the printed feet were made. File frame: print pose (bed at z 0).
  Why: Replaces the printed community-46.stl (stock object 30, the right foot).
  sha256 b2d9a099b2192c50ffe52a31e7cb7ddbabe7d2fa56a69cffb6c0a464823f012e
- **Lower head shell (upper lip printed on, no beak-roof window)** (`stl/our-parts/Yellow/head_bottom.stl`), x1, V1.8, printed. Size 91.8 x 116.7 x 20.1 mm.
  Pose: V1.6 final lower-shell flat pose (final-V1.6.json head_bottom.sourceToPrint); the source frame is the same robot frame File frame: print pose (bed at z 0), rotated here with the release sourceToPrint matrix.
  Why: V1.8 lower head shell: the V1.6 shell with the square beak-roof window filled completely (the raised Pi no longer needs it), and the upper lip pad (source p.obj / ID40) printed as part of the shell instead of being glued in after closing, which had covered the two front closure screws; a 5.2 mm driver hole runs through the lip under each front screw.
  sha256 051be34cbdce7b4e66ceb011f11477eea6c10ee3f5d3f47627dd4280aa41f9fd
- **Jaw frame with the lower lip** (`stl/our-parts/Yellow/jaw_frame.stl`), x1, V1.8, printed. Size 91.4 x 69.4 x 29.0 mm.
  Pose: 10/1 batch jaw frame pose (copy-manifest object 14, community-4.stl), recovered by registering that print mesh to the source jaw (vertex-identical, residual 1e-8); the source frame is the same robot frame File frame: print pose (bed at z 0), rotated here with the release sourceToPrint matrix.
  Why: V1.8 jaw frame: the 10/1 jaw frame (source 4.obj / ID4) with the lower lip pad (source q.obj / ID42) printed as part of it instead of glued into its pocket, so no joint in the beak is glued and the whole beak is yellow.
  sha256 31dde54d43d1f905082762b786b54fb9665382b1e03184473e01256bfc242ef7

### Orange (15 parts)

- **Left ankle inner half, on the sleeve (round bore)** (`stl/our-parts/Orange/ankle_inner_left.stl`), x1, V1.25, released 2026-10-20; the robot carries the V1.24 halves. Size 36.5 x 25.5 x 19.5 mm.
  Pose: local +x down (toe end on the bed, shaft flat, round bore): the builder 2026-10-20 on the printed V1.24 teardrop: the d15 pocket and the d14 lip bore stay round and support may stand in the hole. File frame: print pose (bed at z 0).
  Why: New part, with ankle_outer_left replacing the printed community-66.stl (stock object 20); it also replaces the V1.22 ankle side.
  sha256 8e17b0fda506233ab198867a195efd224d7ded440491d6dcec00964365bf8451
- **Right ankle inner half, on the sleeve (round bore)** (`stl/our-parts/Orange/ankle_inner_right.stl`), x1, V1.25, released 2026-10-20; the robot carries the V1.24 halves. Size 36.5 x 25.5 x 19.5 mm.
  Pose: local -x down (toe end on the bed; the right frame mirrors x): the builder 2026-10-20 on the printed V1.24 teardrop: the d15 pocket and the d14 lip bore stay round and support may stand in the hole. File frame: print pose (bed at z 0).
  Why: New part, with ankle_outer_right replacing the printed community-64.stl (stock object 22); it also replaces the V1.22 ankle side.
  sha256 ce63dc5ca9f13bb6c746a7f9ff5aa7ca9a0d1914355d6db86b57f48bd98bf0b1
- **Left ankle outer half, on the servo horn** (`stl/our-parts/Orange/ankle_outer_left.stl`), x1, V1.25, released 2026-10-20; the robot carries the V1.24 halves. Size 36.5 x 25.5 x 19.8 mm.
  Pose: local +x down (gusset end face on the bed): The gusset end face on the bed, as the V1.22 base and the 10/07 candidate: the motor mating face, the four output seats and the cut face stand vertical. File frame: print pose (bed at z 0).
  Why: Replaces the printed community-66.stl (stock object 20, the left one-piece ankle bracket) together with ankle_inner_left; it also replaces the V1.22 ankle base.
  sha256 642ba2d62c49be5207df55368de20adf23224ca8b6f3c793c16523b712cac8e8
- **Right ankle outer half, on the servo horn** (`stl/our-parts/Orange/ankle_outer_right.stl`), x1, V1.25, released 2026-10-20; the robot carries the V1.24 halves. Size 36.5 x 25.5 x 19.8 mm.
  Pose: local -x down (gusset end face on the bed; the right frame mirrors x): The gusset end face on the bed, as the V1.22 base and the 10/07 candidate: the motor mating face, the four output seats and the cut face stand vertical. File frame: print pose (bed at z 0).
  Why: Replaces the printed community-64.stl (stock object 22, the right one-piece ankle bracket) together with ankle_inner_right; it also replaces the V1.22 ankle base.
  sha256 a1e9f91fd25d766f41206ca1c2886f853e76f8bda0f2ac96b2bac64bd0842af4
- **Battery backpack cap, 3 mm screw floors** (`stl/our-parts/Orange/battery_backpack_cap.stl`), x1, V1.20, printed. Size 64.1 x 77.0 x 7.4 mm.
  battery route (4-power), designed and printed, backpack not yet on the robot.
  Pose: back-plate/battery-backpack-20261015/bp_checks.json printPoses.cap: outer rear face (robot x -73.75) on the bed, x' = y, y' = z, z' = x as rear_lid; 2301.9 mm2 bed contact, 7.4 mm tall. File frame: print pose (bed at z 0).
  Why: V1.20: the unprinted V1.19 battery backpack cap moved 0.7 mm back with the deeper V1.20 frame.
  sha256 3346bdf372e00a869ce9b77c592fe1d4e3d3eb727ffd67862afedd52151acb70
- **Battery backpack frame (DFR1202 slot widened in V1.31)** (`stl/our-parts/Orange/battery_backpack_frame.stl`), x1, V1.31, released 2026-10-23, not printed. Size 64.1 x 87.0 x 22.1 mm.
  battery route (4-power), designed and printed, backpack not yet on the robot.
  Pose: back-plate/battery-backpack-20261015/bp_checks.json printPoses.frame: rim-down as rear_frame, the frame rim (robot x -66.35, the cap seam) on the bed, x' = y, y' = z, z' = x; 713.1 mm2 bed contact (the wall ring, the solid narrow-tier ... File frame: print pose (bed at z 0).
  Why: V1.31: the V1.20 frame with a wider DFR1202 slot.
  sha256 4764606a5668ff6b502a02a45803f6d2a8922f299cddaf8160220f87ee2fa00d
- **Neck wire clip, bracket (printed, not fitted)** (`stl/our-parts/Orange/clip_bracket_v19.stl`), x1, V1.9, printed. Size 12.8 x 6.4 x 7.0 mm.
  printed but not fitted: the head wires run free down the left side of the neck.
  Pose: ext-v19/manifest-ext-v19.json: tab seat face on the bed, screw hole vertical; 67.91 mm2 contact File frame: print pose (bed at z 0), rotated here with the release sourceToPrint matrix.
  Why: New V1.9 part: neck bracket cable clip, a 2 mm tab under S11-horn-040 on the head-pitch axis with a 4.8 x 4.8 mm channel (2.4 mm slot), rounded mouth corners and 1.5 mm end chamfers.
  sha256 26eeca4db87229dc9cbd83494952254b3c70aa9a90c50df77301462f975fe39a
- **Cap wire clip with the micro HDMI notch (printed, not fitted)** (`stl/our-parts/Orange/clip_cap_a7z.stl`), x1, V1.17, printed. Size 13.3 x 17.8 x 6.0 mm.
  printed but not fitted: the head wires run free down the left side of the neck.
  Pose: V1.9 cap clip pose, release-V1.9/manifest-V1.9.json clip_cap_v19.sourceToPrint (scripts/pose-sources-a7z.json): tab seat face on the bed, screw hole vertical; 25.1 mm2 true contact, 6.0 mm tall, tip angle 54.7 deg. File frame: print pose (bed at z 0), rotated here with the release sourceToPrint matrix.
  Why: A7Z cap clip (a7z-head/build_a7z_head.py, checks.json clip): the V1.9 cap clip with a notch cut into its underside over the A7Z micro HDMI socket, which overhangs the board edge by 1.6 mm where the clip arm crossed it (0.6 mm clearance all round).
  sha256 531909bdab5b47c31461488f1d259429cee20a27a2ca06112a9f53d1c11b3aa5
- **Neck wire clip, head end (printed, not fitted)** (`stl/our-parts/Orange/clip_head_v19.stl`), x1, V1.9, printed. Size 13.7 x 15.1 x 11.2 mm.
  printed but not fitted: the head wires run free down the left side of the neck.
  Pose: ext-v19/manifest-ext-v19.json: tab seat face on the bed, screw hole vertical; 119.97 mm2 contact File frame: print pose (bed at z 0), rotated here with the release sourceToPrint matrix.
  Why: New V1.9 part: head cable clip, a 2 mm tab under H-jaw_support-03 with a channel that takes the bundle down and out through a side window.
  sha256 590caacb96cd79e81493c29d58f9c5d8bb5fbf8d24f799befdaf36b9f381dac0
- **Neck wire clip, torso end (printed, not fitted)** (`stl/our-parts/Orange/clip_torso_v19.stl`), x1, V1.9, printed. Size 10.8 x 10.3 x 8.9 mm.
  printed but not fitted: the head wires run free down the left side of the neck.
  Pose: ext-v19/manifest-ext-v19.json: tab seat face on the bed, screw hole vertical; 60.26 mm2 contact File frame: print pose (bed at z 0), rotated here with the release sourceToPrint matrix.
  Why: New V1.9 part: torso cable clip, a 2 mm tab under S12-horn-025 with a 4.8 x 4.8 mm channel (2.4 mm slot) for the 8-wire neck bundle.
  sha256 1f16d613216cf03d2b20bd3baa1d87b7a9e14ba1d32e51fc243ddf1c446164fc
- **head cap** (`stl/our-parts/Orange/head_cap.stl`), x1, V1.8, printed. Size 126.5 x 91.6 x 47.1 mm.
  Pose: V1.6/V1.7 cap flat pose expressed in the robot frame: worldToFlatPrint = sourceToPrint @ worldToStlFrame from candidates/head-cap-pi-shift/manifest.json (same 104.39 mm2 bed contact and bounds) File frame: print pose (bed at z 0), rotated here with the release sourceToPrint matrix.
  Why: V1.8 head cap: the V1.7 cap (Pi seat 4.6 mm back, +y rail trimmed) with both Pi rails raised 1.0 mm so the plugged jumper housings clear the lower shell without a beak window, and the two unused rear roof bosses removed.
  sha256 b967d05bf85ae0ad101af31c4e663ed0004877fd85f7dcc0ed2e505b7c8bb51a
- **Rear converter box frame (layout F)** (`stl/our-parts/Orange/rear_frame.stl`), x1, V1.17, printed. Size 64.1 x 87.0 x 21.6 mm.
  Pose: back-plate/layout-F/build.json printPoses.frame and back-plate/layout-F/rear_frame-print.stl: rim-down, the frame rim (robot x -59.1, the cap seam) on the bed, x' = y, y' = z, z' = x; 252.0 mm2 bed contact (the 1.2 mm wall ring alone on a ... File frame: print pose (bed at z 0).
  Why: V1.16 rear converter box frame, layout F regenerated from build_f.py (back-plate/layout-F/README.md): the V1.11 frame with the two cap-screw ear bosses and their webs removed, the front passage P1 filled (solid front plate) and no tooth slots or hook notch (the builder 2026-10-15: the cap is held by screws only).
  sha256 b684a957a5510fcba5a3c290267a632e15bb1d90e98c0eda3621654a00ac5e22
- **Rear converter box cap, 3 mm screw floors** (`stl/our-parts/Orange/rear_lid.stl`), x1, V1.20, printed. Size 64.1 x 79.0 x 14.5 mm.
  Pose: back-plate/layout-F/build.json printPoses.lid and back-plate/layout-F/rear_lid-print.stl: outer rear face (robot x -67.1) on the bed, x' = y, y' = z, z' = x; 2634.0 mm2 bed contact, 12.5 mm tall (open side up, no tongues). File frame: print pose (bed at z 0).
  Why: V1.20: the V1.19 layout F cap, unprinted, carried unchanged.
  sha256 05fd5baad85660da01c9e3b60609bf571ee77c6b265f307f71f6cd137e1ba68d
- **Rear electronics pack (OpenRB-150 upright, BNO085 rib, shell seat bars)** (`stl/our-parts/Orange/rear_pack.stl`), x1, V1.9, printed. Size 32.0 x 55.2 x 83.2 mm.
  Pose: V1.8 rear_pack pose (release-V1.8/scripts/rows.json): upright as in the robot, floor (robot z -44) on the bed; 660.6 mm2 bed contact, rank 1 of 11 in rear-pack-v19/orientation-check.json. File frame: print pose (bed at z 0), rotated here with the release sourceToPrint matrix.
  Why: V1.9 rear electronics pack: a BNO085 rib on the plate front face with two M2 x 4 pilots replaces the shelf and its zip-tie slots (the board is screwed on at the bench before pack-in); the T-head is grown 0.4 mm all round and two 3 mm shoulder bars behind the plate seat the printed V1.8 side shells (roof gap 0.15 mm left, 0.27 mm right instead of 0.55/0.71).
  sha256 09dad21e8cead197be99c125a05d3d0c97b4910dcf5eafeea1c83ecd10841331
- **Speaker retainer frame in the head cap** (`stl/our-parts/Orange/speaker_retainer_v19.stl`), x1, V1.9, printed. Size 33.7 x 35.6 x 1.6 mm.
  Pose: ext-v19/manifest-ext-v19.json: flat on its speaker-side face; 367.61 mm2 contact File frame: print pose (bed at z 0), rotated here with the release sourceToPrint matrix.
  Why: New V1.9 part: 1.6 mm speaker retainer frame that holds the speaker and its 1 mm foam ring in the cap roof collar with two M2 x 6 screws (no glue).
  sha256 cb8e300544069467ab11ebba483197cc7215aeeb892214f95c8ae95655707fb9

### Black (9 parts)

- **Left ankle sleeve, 10.4 mm bore** (`stl/our-parts/Black/ankle_sleeve_left.stl`), x1, V1.22, printed. Size 14.6 x 14.6 x 2.8 mm.
  Pose: local -Z down (axial, 10/07 pose; +Z down is identical by symmetry): Axial, local -Z down, the 10/07 candidate pose (the mesh is exactly symmetric in z, so +Z down is the same print). File frame: print pose (bed at z 0).
  Why: Replaces the printed community-62.stl (stock object 148, the left 9.65 mm ankle sleeve): bore 10.4 mm instead of 9.65 mm on the 10 mm link boss (the stock sleeve is a 14.96 mm3 press fit, ankle-split-check.json sleeveOnLinkBoss), OD 14.6 mm, 2.8 mm wide with 0.2 mm entry chamfers, so it slides on by hand and runs free.
  sha256 cece343cad5617c33fdc7c4062b3fc02231729749cdcb2c75c4003e196067e0e
- **Eye trim** (`stl/our-parts/Black/eye_trim.stl`), x1, V1.8, printed. Size 30.0 x 30.0 x 9.4 mm.
  Pose: V1.6 eye-trim print pose expressed in the robot frame: inverse of the V1.6 registration transformReleaseToWorld (interference-audit register_v16), dropped to the bed File frame: print pose (bed at z 0), rotated here with the release sourceToPrint matrix.
  Why: V1.8 eye trim: as V1.6 plus two 1.7 mm pilots (x 81.3..87.0 at z 120.6 and 141.6) for the M2 x 8 camera screws.
  sha256 87ba48b2763dda08fd91990695293784819d084ac8e97b152238036110e45e1d
- **Jaw support (open, original style)** (`stl/our-parts/Black/jaw_support_original.stl`), x1, V1.6, printed. Size 54.2 x 73.5 x 18.8 mm.
  Pose: as released File frame: print pose (bed at z 0), rotated here with the release sourceToPrint matrix.
  Why: Restore original community24 jaw support, replacing the coaxial support actually supplied in the printed89-piece stock.
  sha256 6e0ea397cafa8fcffb6dba96d36dd78dd1c0b1c834098416718b0e90feea44a9
- **Right lower-leg link with the ankle sleeve printed on** (`stl/our-parts/Black/lower_right.stl`), x1, V1.28, printed. Size 20.0 x 59.3 x 8.0 mm.
  Pose: 10/1 pose of the stock link, flat, 8.05 mm tall, 174.7 mm2 contact. File frame: print pose (bed at z 0).
  Why: One-piece lower-leg link: the stock link with the V1.22 ankle sleeve (OD 14.6, 2.8 wide) printed on its 10 mm boss (the builder 2026-10-22); same seated contacts and assembly paths as link + sleeve (link-check.json).
  sha256 0b78e7947001a829a6df586393cf7401ce5da0fdc596898eb90ec39a9f70e106
- **Jaw sliding ring** (`stl/our-parts/Black/mouth_sliding_ring.stl`), x1, V1.6, printed. Size 16.4 x 16.4 x 2.4 mm.
  Pose: as released File frame: print pose (bed at z 0), rotated here with the release sourceToPrint matrix.
  Why: Separate thin retaining ring used with restored original jaw support; no corresponding original89 stock part.
  sha256 61a6dd8b12a9f5d7d4f8608722ecf896d8c2d2d08e75b79f082049d7386e4ce1
- **Neck pitch bracket with integral 1 mm screw seats** (`stl/our-parts/Black/neck_pitch_integrated_1mm_seats.stl`), x1, V1.6, printed. Size 35.0 x 18.0 x 27.7 mm.
  Pose: as released File frame: print pose (bed at z 0), rotated here with the release sourceToPrint matrix.
  Why: User selected integral1mm screw-head seats for M2x6; replaces community28, not stock object36/community70.
  sha256 e9b7b677965da84c229920387c4cdd35057f1b2c0cedd371a01f39aead939b45
- **Head-pitch sliding ring** (`stl/our-parts/Black/neck_pitch_ring.stl`), x1, V1.8, printed. Size 22.0 x 22.0 x 4.9 mm.
  Pose: Flat, axis vertical, as the 10/1 4 mm ring (plate-05/17_community-102.stl). File frame: print pose (bed at z 0), rotated here with the release sourceToPrint matrix.
  Why: Neck pitch ring lengthened from 4.0 to 4.9 mm.
  sha256 ef3a2f9304289fe56a3b5eaf0d0a784b31fe6a3e4a85cbcbb4fc4a11c80c93eb
- **Head-pitch ring shim, 1 mm (optional)** (`stl/our-parts/Black/neck_ring_shim_1mm.stl`), x1, V1.8, printed. Size 22.0 x 22.0 x 1.0 mm.
  optional shim, fit only if the head-pitch ring has play.
  Pose: Flat, axis vertical, like the ring. File frame: print pose (bed at z 0), rotated here with the release sourceToPrint matrix.
  Why: Optional 1 mm shim with the ring bore (16.4 mm) and outside (22 mm).
  sha256 adb2fa489209b14e0ef709af2f87f10b992b69e8e3cd8cce599d6e6e6c1ced4a
- **Head-pitch ring shim, 2 mm (optional)** (`stl/our-parts/Black/neck_ring_shim_2mm.stl`), x1, V1.8, printed. Size 22.0 x 22.0 x 2.0 mm.
  optional shim, fit only if the head-pitch ring has play.
  Pose: Flat, axis vertical, like the ring. File frame: print pose (bed at z 0), rotated here with the release sourceToPrint matrix.
  Why: Optional 2 mm shim with the ring bore (16.4 mm) and outside (22 mm).
  sha256 380223eb89e56ede84888cfd77eb4f955c6d42e9b9adb71894f901b65cf0b704

### Tools, not included

- **Left foot sole mold (tool)** (V1.21): sole mold for the hot-glue route dropped on 2026-10-19; STL not included, the soles are cut from a bicycle inner tube.
- **Right foot sole mold (tool)** (V1.21): sole mold for the hot-glue route dropped on 2026-10-19; STL not included, the soles are cut from a bicycle inner tube.

## Community parts kept from the 10/1 batch

58 instances in 44 files, copied to `stl/community/` in the orientation of the 2026-10-01 batch (the same geometry as in the community 3MF). Quantities are the batch counts; the rings, idlers and caps include spares.

- **22 mm printed sliding ring** (`stl/community/community-53.stl`), x1; sha256 b122b8cd53efdad68905ba1c18abdf64468262a2e14fa2d395c7252e66f33f91
- **22 mm printed sliding ring** (`stl/community/community-87.stl`), x1; sha256 f150280c891c25f9ba9ff3ef6ccc162f1e899b24a58ebf936d5f5637e928da87
- **22 mm printed sliding ring** (`stl/community/community-88.stl`), x1; sha256 88e53959f3a62063d76b638c0c5a946e488a6c8c1006ee0a8e2b40e7a9ae414b
- **22 mm printed sliding ring** (`stl/community/community-89.stl`), x1; sha256 d5387a3198d5548528292dc5b5512c8035815bcf158307d9647401cd92a2acf6
- **22 mm printed sliding ring** (`stl/community/community-90.stl`), x1; sha256 88e53959f3a62063d76b638c0c5a946e488a6c8c1006ee0a8e2b40e7a9ae414b
- **22 mm printed sliding ring** (`stl/community/community-91.stl`), x1; sha256 489310f9bd07f066d70e6a4360cd8bcdaa5999f0fd520685fa276007a59ce294
- **22 mm printed sliding ring** (`stl/community/community-92.stl`), x1; sha256 961858cd38c720419224b7ac5e77075e3eaf692550d191ef38d5a505aab9d426
- **22 mm printed sliding ring** (`stl/community/community-93.stl`), x1; sha256 ecd5217b1140598db1d3ce981911c058014db53107792e0dc8d1549becc1e7db
- **22 mm printed sliding ring** (`stl/community/community-94.stl`), x1; sha256 ecd5217b1140598db1d3ce981911c058014db53107792e0dc8d1549becc1e7db
- **22 mm printed sliding ring** (`stl/community/community-95.stl`), x1; sha256 d2e43b66a0d147d7b24df467b91f09f5138313c8c351624144df848d74ced061
- **22 mm printed sliding ring** (`stl/community/community-96.stl`), x1; sha256 5ae77336f826bb020a1e8c187dae4ea35fa2c4b9ccffbfe86479bf87e8b22a9a
- **22 mm printed sliding ring** (`stl/community/community-97.stl`), x1; sha256 c027b124f54d60c1691a97cc9c64b6dc59c82e1603a160cbddae84b041966711
- **22 mm printed sliding ring** (`stl/community/community-98.stl`), x1; sha256 d41814a3869cf53c0a22f5640394a9156d72effeea41b084f35b00e64b458320
- **22 mm printed sliding ring** (`stl/community/community-99.stl`), x1; sha256 d3870e9facf3fd6576516f59a96a26a0e592cb325c9256e09948c7317b8dd729
- **22 mm printed sliding ring** (`stl/community/community-100.stl`), x1; sha256 b4fa7a901e3e76336c2cf02a4f49b3c2847e1151aba2a3720a75ec018107b10a
- **22 mm printed sliding ring** (`stl/community/community-101.stl`), x1; sha256 66ee862c7854cb1842700d1197a672138a062f7a8a0d171ba5eac8a9992b6819
- **22 mm printed sliding ring** (`stl/community/community-103.stl`), x1; sha256 4b0934e9e134e7c28af3ef11aaf898c9e34b9cbe60ab626a01009b4321ddec17
- **Head yaw/roll link** (`stl/community/community-70.stl`), x1; sha256 3a6c05cf399d5b7974ba8a427b2ae647216a1d75b3e7ccf2b1c7a522f9b191ff
- **Hip bracket** (`stl/community/community-14.stl`), x1; sha256 080a160d7b5b514118c908803d34191542c5960192e66241d365a3f1d111ca7c
- **Hip bracket** (`stl/community/community-60.stl`), x1; sha256 8a37a457e689e79dac79e113ff883821d197540b953068b92cd24cb8785c943a
- **Hip yaw/roll link A** (`stl/community/community-36.stl`), x1; sha256 11527480ec4fcccbc71ebed70867895711d55c533bb7862a73fd9cee4a558bfb
- **Hip yaw/roll link B** (`stl/community/community-38.stl`), x1; sha256 a6f6f04c0ea32e971c3fab7124357f87fd3732dd9a15bfc67b75110dc48207fb
- **Lower-leg link A** (`stl/community/community-30.stl`), x1; sha256 a1c95b38c3e759f5be201dd85a16dae2e66b23c2d3faa9eb3201ab457cf108fa
- **Neck link A** (`stl/community/community-16.stl`), x1; sha256 0e5738da8d515a1b964482c7bd7643c3244dbd3a77936ceefafae20a0f7fc6f4
- **Neck link B** (`stl/community/community-18.stl`), x1; sha256 0e5738da8d515a1b964482c7bd7643c3244dbd3a77936ceefafae20a0f7fc6f4
- **Passive roll support** (`stl/community/community-50.stl`), x1; sha256 ede0f57b768e64c97041a266a535dcac96818ef36cf353d5485541091dfb76f0
- **Passive roll support** (`stl/community/community-51.stl`), x1; sha256 ede0f57b768e64c97041a266a535dcac96818ef36cf353d5485541091dfb76f0
- **Printed idler cap** (`stl/community/community-59.stl`), x9; sha256 70f8aa0de4b35500d22967a68e4e6d4f5473ca1994a7da53851301346bf79c87
- **Printed idler cap** (`stl/community/community-78.stl`), x1; sha256 d01cf7c500b5317d86d5b426315febb4ddeb9826e91f13c16870048eded84639
- **Printed idler cap** (`stl/community/community-80.stl`), x1; sha256 2e70313cfaafaec997cad22e2cc234951779dc6f8ff20dd410f4d5c5ed8281ac
- **Printed idler cap** (`stl/community/community-82.stl`), x1; sha256 70f8aa0de4b35500d22967a68e4e6d4f5473ca1994a7da53851301346bf79c87
- **Printed idler cap** (`stl/community/community-84.stl`), x1; sha256 d01cf7c500b5317d86d5b426315febb4ddeb9826e91f13c16870048eded84639
- **Printed idler cap** (`stl/community/community-86.stl`), x1; sha256 2e70313cfaafaec997cad22e2cc234951779dc6f8ff20dd410f4d5c5ed8281ac
- **Printed passive idler** (`stl/community/community-55.stl`), x7; sha256 b9ed56e4e85bbdb70e05843d09022ec0c1f45507be45cca5a35ff56fbc6628a6
- **Printed passive idler** (`stl/community/community-56.stl`), x1; sha256 5f78a0177d8ffb3ea50cd293831abd2357998dbf32b2b4d7ca03ebce4c72b15d
- **Printed passive idler** (`stl/community/community-57.stl`), x1; sha256 07c1171b4fdc6351c74e20b9448469374cc7591a06f84a562018fb6feb79cf87
- **Printed passive idler** (`stl/community/community-77.stl`), x1; sha256 2c2a69639ee7b891babec573fe9bb30560ac8fc1a1549658eac67b73f2464bf3
- **Printed passive idler** (`stl/community/community-79.stl`), x1; sha256 2c2a69639ee7b891babec573fe9bb30560ac8fc1a1549658eac67b73f2464bf3
- **Printed passive idler** (`stl/community/community-81.stl`), x1; sha256 67b29f8d9e086d5a6c1f8ad1af2275307b7ec59ffe9584dc918e916a30a169a5
- **Printed passive idler** (`stl/community/community-83.stl`), x1; sha256 2c2a69639ee7b891babec573fe9bb30560ac8fc1a1549658eac67b73f2464bf3
- **Printed passive idler** (`stl/community/community-85.stl`), x1; sha256 2c2a69639ee7b891babec573fe9bb30560ac8fc1a1549658eac67b73f2464bf3
- **Thigh reinforcing plate A** (`stl/community/community-20.stl`), x1; sha256 386bbc31603a6b6ba58d0d47307425ae2a4e09f0845c8329839fa2f5ad1ab87f
- **Thigh reinforcing plate B** (`stl/community/community-22.stl`), x1; sha256 4fa5a1d6573b1b444ee15d5df53582c5ecf7f1bbb0d14587835004640dbf148b
- **Torso base** (`stl/community/community-34.stl`), x1; sha256 513132dd3e7265ee8c202f3ed83c74fba7bd0938dfa9a682351268966c1f52ff

## Community parts not used any more

Printed on 2026-10-01 and later taken off the robot or never fitted. Do not print these from the community 3MF.

- Integrated power support (batch instance 0): replaced by the V1.8 rear electronics pack
- Small-regulator cover (batch instance 1): no small regulator in this build
- Jaw-clearance head cap with USB service window (batch instance 2): replaced by the head cap releases
- Torso IMU clamp (batch instance 3): the BNO085 sits on the V1.9 rear pack rib
- IMU rear cover (batch instance 4): same
- Eleven-fuse carrier (batch instance 5): no fuses in the harness
- Coaxial jaw motor support (batch instance 6): the open jaw support (V1.6 jaw_support_original) is used instead
- Lower head shell (batch instance 7): replaced by the V1.8 lower head shell
- Moving jaw frame (batch instance 8): replaced by the V1.8 jaw frame with the lower lip
- Left shell (batch instance 9): replaced by the white V1.17 left torso shell
- Right shell (batch instance 10): replaced by the white V1.17 right torso shell
- Original PCB retaining strip (batch instance 17): battery-bay part of the upstream design, not used
- Neck U bracket (batch instance 18): replaced by the V1.6 neck pitch bracket with integral screw seats
- Lower-leg link B (batch instance 20): replaced by V1.28 lower_right
- Fixed upper lip pad (batch instance 24): printed as part of the V1.8 lower head shell
- Moving lower lip pad (batch instance 25): printed as part of the V1.8 jaw frame
- Community foot A, combined mesh (batch instance 26): replaced by V1.22 foot_left_slipfit
- Community foot B, combined mesh (batch instance 27): replaced by V1.22 foot_right_slipfit
- Eye outer ring (batch instance 28): replaced by the eye trim
- 22 mm printed sliding ring (batch instance 47): replaced by V1.8 neck_pitch_ring
- 14.6 mm printed ankle ring (batch instance 77): replaced by V1.22 ankle_sleeve_left
- 14.6 mm printed ankle ring (batch instance 78): replaced by V1.22 ankle_sleeve_right
- Community right ankle (batch instance 79): replaced by V1.25 ankle_outer_right
- Community left ankle (batch instance 80): replaced by V1.25 ankle_outer_left
- Right thigh (batch instance 82): replaced by V1.17 thigh_right
- Left thigh (batch instance 83): replaced by V1.17 thigh_left
- Face panel and Pi mount (batch instance 84): replaced by the face panel releases
- Open regulator insert (batch instance 85): replaced by the V1.8 rear electronics pack
- Camera tilt foot (batch instance 86): the camera sits in the eye
- Camera cradle (batch instance 87): same
- Audio carrier (batch instance 88): the speaker sits in the V1.9 retainer in the head cap

## Our parts that a later release replaced

Listed so an old plate file is not printed by mistake.

- head_cap (V1.6), retired by V1.7: same part re-released
- openrb_tray (V1.6), retired by V1.7: same part re-released
- openrb_tray (V1.7), retired by V1.8: manifest-V1.8.json: the rear electronics pack replaces the OpenRB tray
- imu_cover (V1.6), retired by V1.8: manifest-V1.8.json: the rear electronics pack replaces the IMU clamp and cover
- imu_clamp (V1.6), retired by V1.8: manifest-V1.8.json: the rear electronics pack replaces the IMU clamp and cover
- camera_retainer (V1.6), retired by V1.8: manifest-V1.8.json: the V1.8 face plate carries direct camera screws
- head_bottom (V1.6), retired by V1.8: same part re-released
- face_panel (V1.6), retired by V1.8: same part re-released
- head_cap (V1.7), retired by V1.8: same part re-released
- eye_trim (V1.6), retired by V1.8: same part re-released
- speaker_cradle (V1.6), retired by V1.9: the V1.9 speaker retainer in the head cap replaces the V1.6 speaker cage (guide/content/build_guide_data.py)
- speaker_keeper (V1.6), retired by V1.9: same
- rear_pack (V1.8), retired by V1.9: same part re-released
- rear_pack_cover (V1.8), retired by V1.17: replaced by the V1.11 rear_frame, which carries the same cover outline, holes and lip
- head_cap_v19 (V1.9), retired by V1.17: replaced by the white A7Z head cap; keep as a spare for the Pi Zero W
- face_panel (V1.8), retired by V1.17: replaced by the A7Z face panel: its back carries the Camera Module 3 lands and pegs, not the 13M 214 bosses
- clip_cap_v19 (V1.9), retired by V1.17: replaced by the A7Z cap clip: its arm crosses the A7Z micro HDMI socket
- rear_lid (V1.17), retired by V1.20: its two low 1.0 mm screw floors tore through (IMG_7004); replaced by the V1.20 cap (the unprinted V1.19 design) on the same four M2 x 10
- ankle_base_left (V1.22), retired by V1.24: V1.22 split-ankle base: thin screw posts that catch the servo wire; replaced by ankle_outer_left
- ankle_cheek_left (V1.22), retired by V1.24: V1.22 split-ankle side: thin screw posts that catch the servo wire; replaced by ankle_inner_left
- ankle_base_right (V1.22), retired by V1.24: V1.22 split-ankle base: thin screw posts that catch the servo wire; replaced by ankle_outer_right
- ankle_cheek_right (V1.22), retired by V1.24: V1.22 split-ankle side: thin screw posts that catch the servo wire; replaced by ankle_inner_right
- ankle_inner_left (V1.24), retired by V1.25: V1.24 inner half with the 45 deg teardrop sleeve pocket; replaced by the round-bore ankle_inner_left
- ankle_inner_right (V1.24), retired by V1.25: V1.24 inner half with the 45 deg teardrop sleeve pocket; replaced by the round-bore ankle_inner_right
- ankle_outer_left (V1.24), retired by V1.25: same part re-released
- ankle_outer_right (V1.24), retired by V1.25: same part re-released
- ankle_sleeve_right (V1.22), retired by V1.28: manifest-V1.28.json: the right link carries its sleeve printed on
- battery_backpack_frame (V1.20), retired by V1.31: the DFR1202 does not go between its clip arms; replaced by the V1.31 frame with the wider slot
