qilinxiaoxiang/cmu-microduck/1-printing/stl/community/community-30.stl

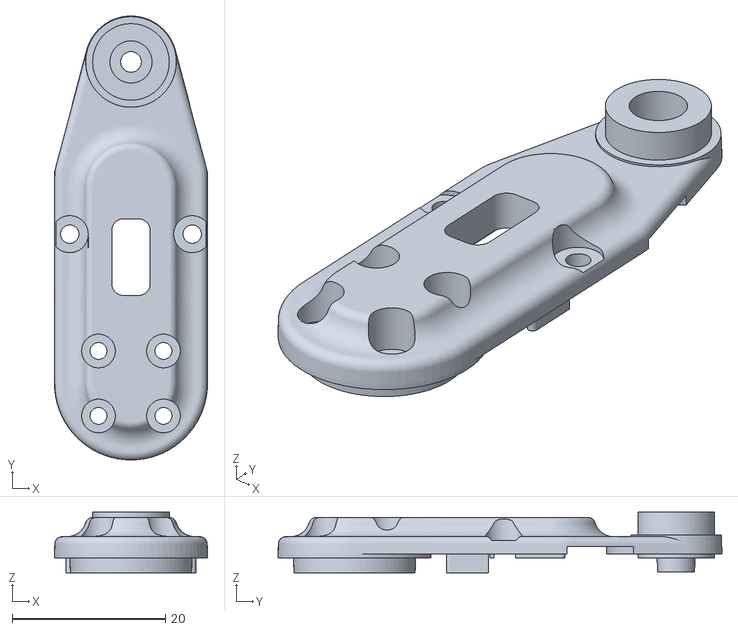
[picture p18: CAD file, 2026-10-24]
1-printing/stl/community/community-30.stl
20.0 x 58.0 x 7.95
