qilinxiaoxiang/cmu-microduck/1-printing/stl/our-parts/Black/eye_trim.stl

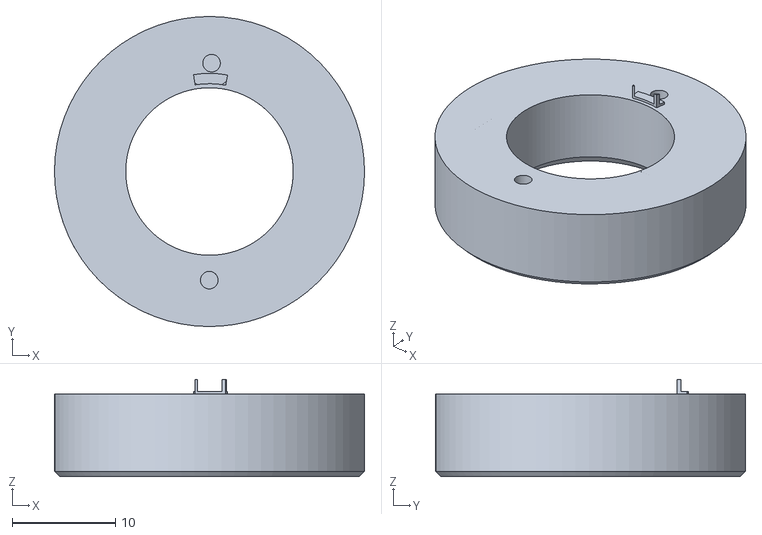
[picture p19: CAD file, 2026-10-24]
1-printing/stl/our-parts/Black/eye_trim.stl
30.0 x 30.0 x 9.40
