qilinxiaoxiang/cmu-microduck/1-printing/stl/our-parts/Orange/ankle_outer_left.stl

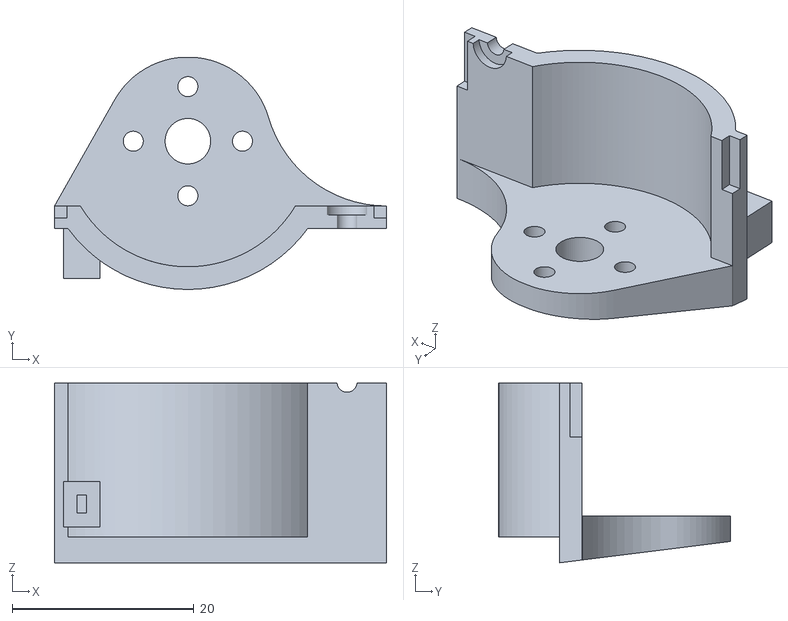
[picture p20: CAD file, 2026-10-24]
1-printing/stl/our-parts/Orange/ankle_outer_left.stl
36.5 x 25.5 x 19.8
