qilinxiaoxiang/cmu-microduck/1-printing/stl/our-parts/White/head_cap_a7z.stl

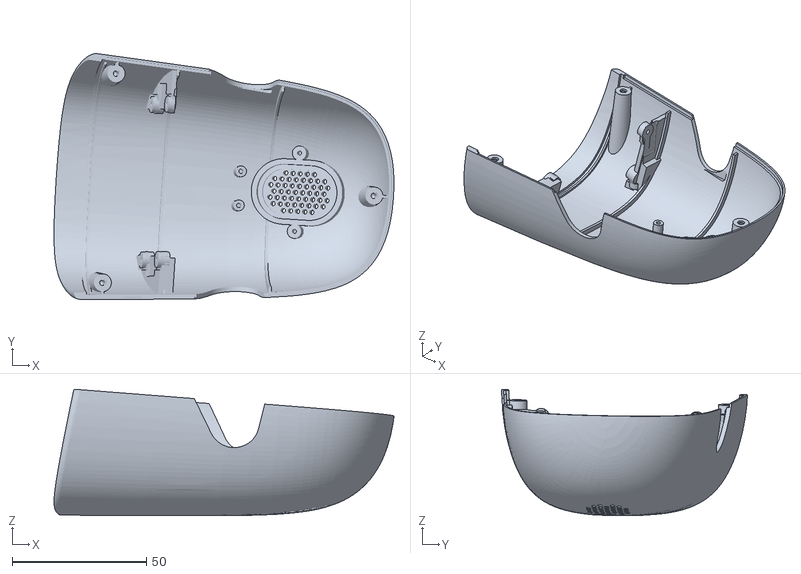
[picture p21: CAD file, 2026-10-24]
1-printing/stl/our-parts/White/head_cap_a7z.stl
126.5 x 91.6 x 47.1
