qilinxiaoxiang/cmu-microduck/1-printing/stl/our-parts/Yellow/head_bottom.stl

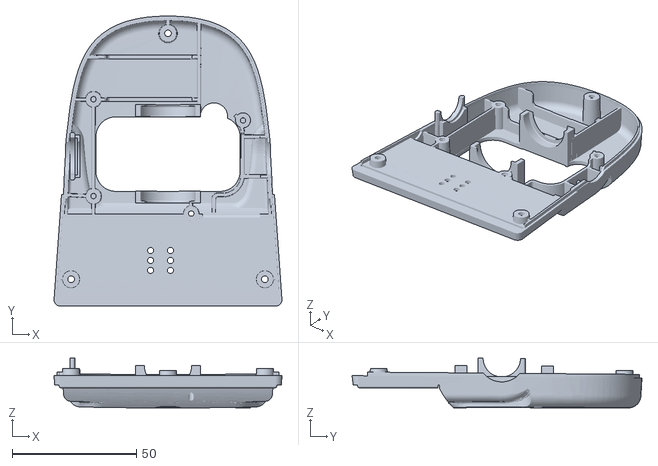
[picture p22: CAD file, 2026-10-24]
1-printing/stl/our-parts/Yellow/head_bottom.stl
91.8 x 116.7 x 20.1
