qilinxiaoxiang/cmu-microduck/4-power/battery-backpack/battery_backpack_cap-V1.20-print.stl

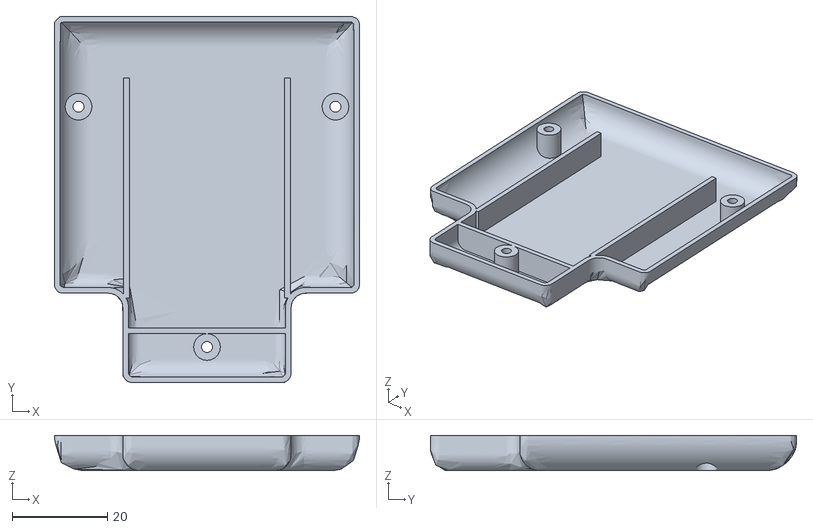
[picture p23: CAD file, 2026-10-24]
4-power/battery-backpack/battery_backpack_cap-V1.20-print.stl
64.1 x 77.0 x 7.40
