qilinxiaoxiang/cmu-microduck/1-printing/stl/community/community-80.stl

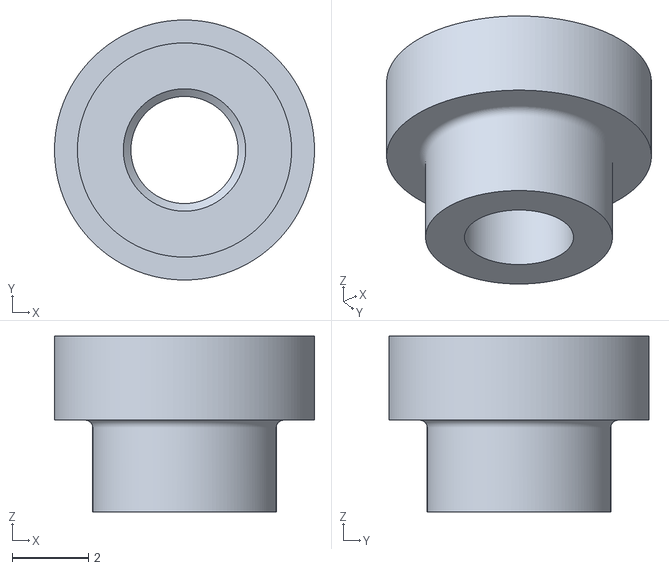
[picture p24: CAD file, 2026-10-24]
1-printing/stl/community/community-80.stl
6.80 x 6.80 x 4.60
