qilinxiaoxiang/cmu-microduck/1-printing/stl/our-parts/Black/jaw_support_original.stl

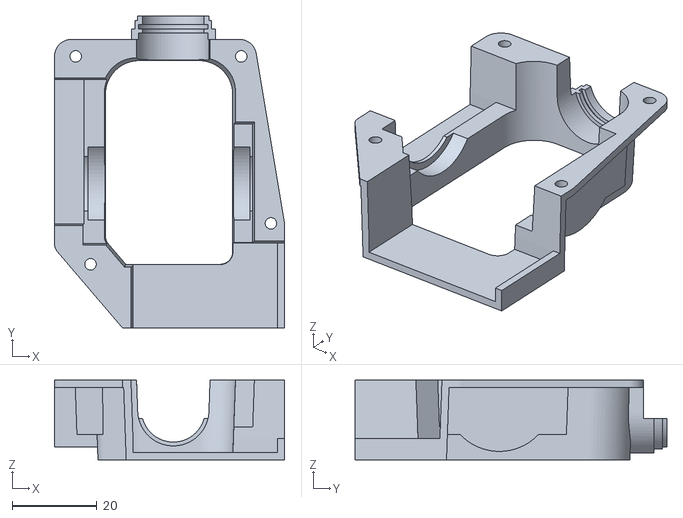
[picture p25: CAD file, 2026-10-24]
1-printing/stl/our-parts/Black/jaw_support_original.stl
54.2 x 73.5 x 18.8
