qilinxiaoxiang/cmu-microduck/1-printing/stl/our-parts/Orange/clip_torso_v19.stl

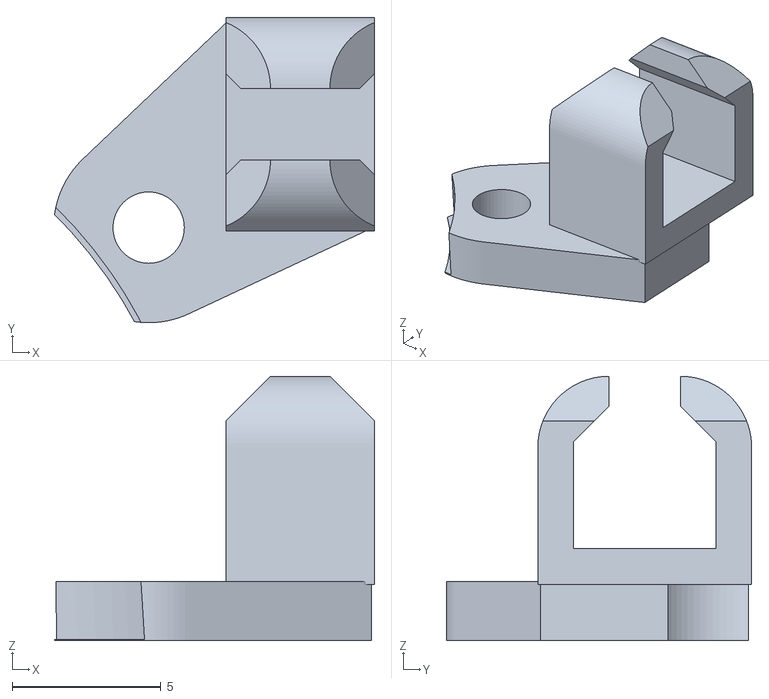
[picture p26: CAD file, 2026-10-24]
1-printing/stl/our-parts/Orange/clip_torso_v19.stl
10.8 x 10.3 x 8.90
