qilinxiaoxiang/cmu-microduck/1-printing/stl/our-parts/White/face_panel_a7z.stl

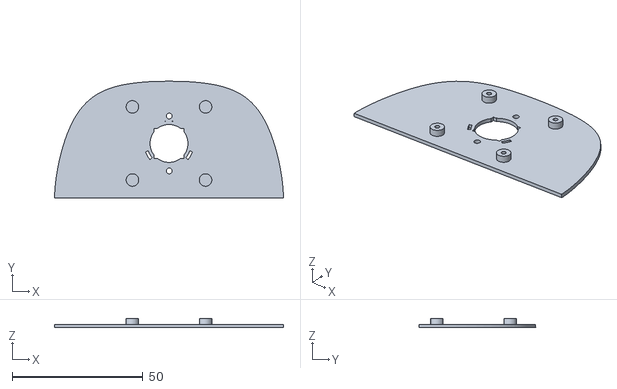
[picture p27: CAD file, 2026-10-24]
1-printing/stl/our-parts/White/face_panel_a7z.stl
87.7 x 44.6 x 3.60
