qilinxiaoxiang/cmu-microduck/1-printing/stl/our-parts/Yellow/foot_right_slipfit.stl

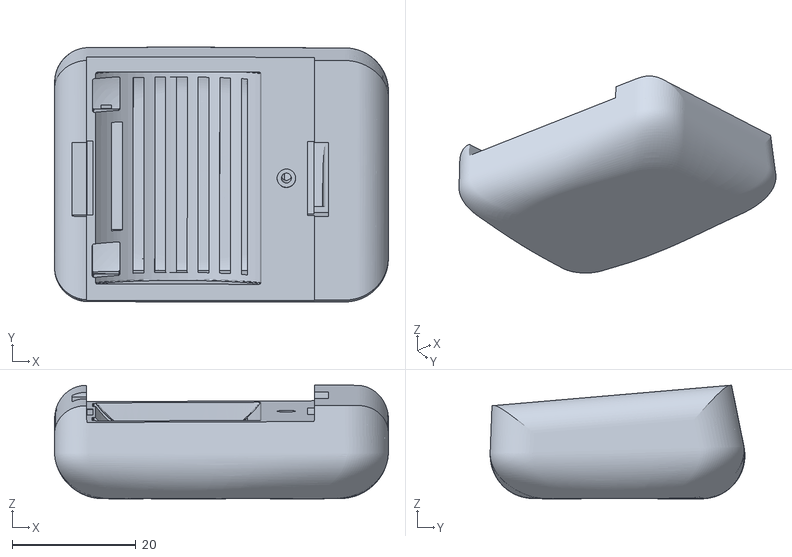
[picture p28: CAD file, 2026-10-24]
1-printing/stl/our-parts/Yellow/foot_right_slipfit.stl
54.0 x 41.2 x 18.4
