qilinxiaoxiang/cmu-microduck/4-power/battery-backpack/battery_backpack_frame-V1.31-print.stl

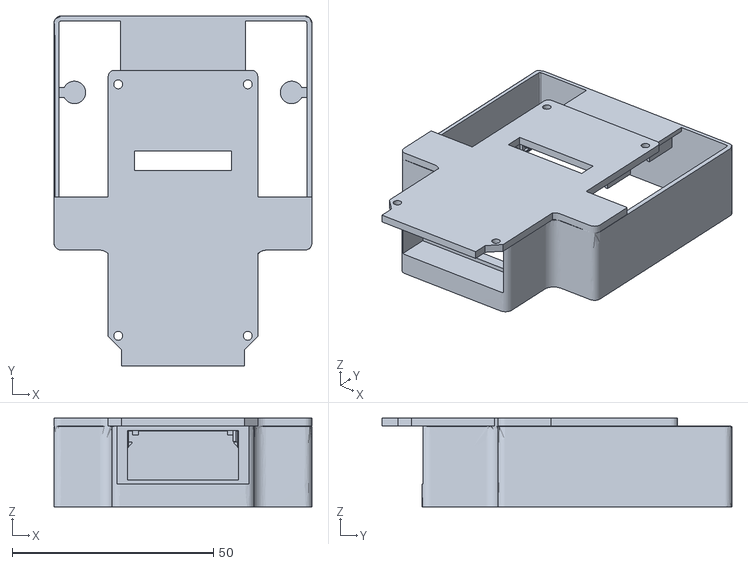
[picture p29: CAD file, 2026-10-24]
4-power/battery-backpack/battery_backpack_frame-V1.31-print.stl
64.1 x 87.0 x 22.1
