qilinxiaoxiang/cmu-microduck/1-printing/stl/community/community-90.stl

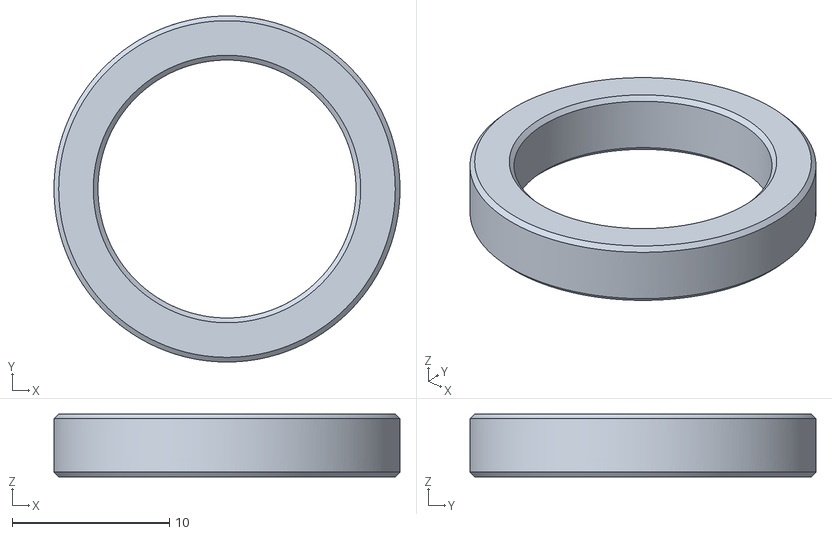
[picture p30: CAD file, 2026-10-24]
1-printing/stl/community/community-90.stl
22.0 x 22.0 x 4.00
