qilinxiaoxiang/cmu-microduck/1-printing/stl/our-parts/Black/mouth_sliding_ring.stl

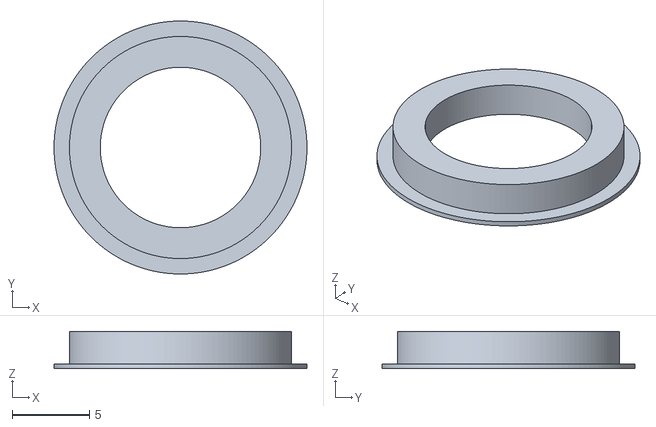
[picture p31: CAD file, 2026-10-24]
1-printing/stl/our-parts/Black/mouth_sliding_ring.stl
16.4 x 16.4 x 2.40
