qilinxiaoxiang/cmu-microduck/1-printing/stl/our-parts/Orange/speaker_retainer_v19.stl

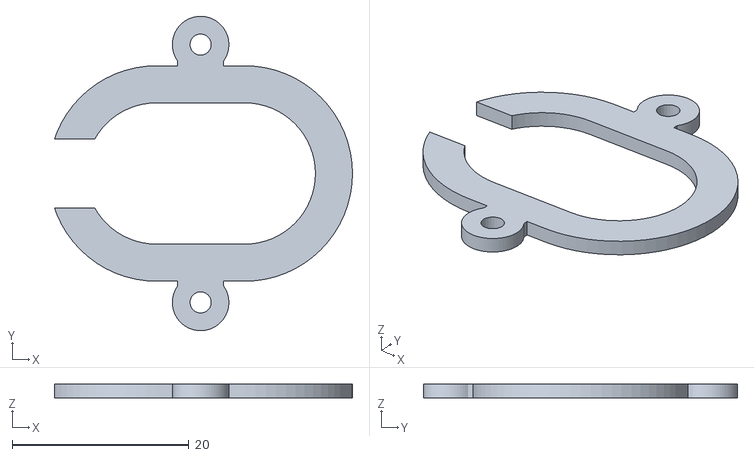
[picture p32: CAD file, 2026-10-24]
1-printing/stl/our-parts/Orange/speaker_retainer_v19.stl
33.7 x 35.6 x 1.60
