qilinxiaoxiang/cmu-microduck/1-printing/stl/our-parts/White/thigh_right.stl

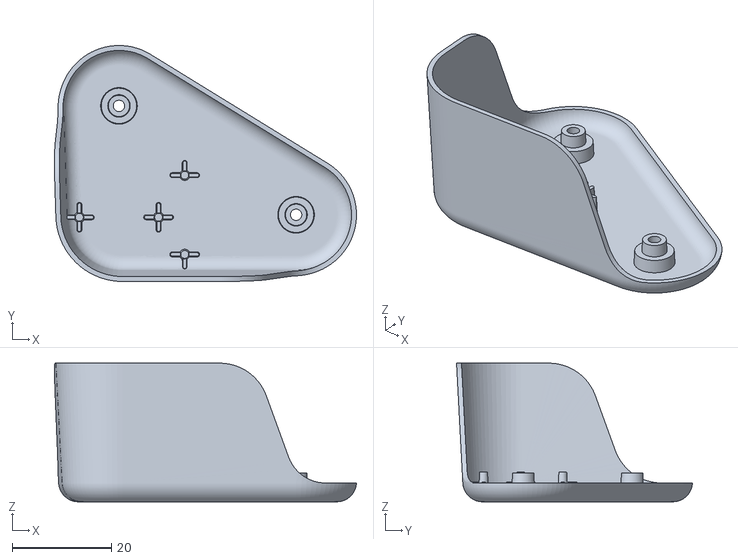
[picture p33: CAD file, 2026-10-24]
1-printing/stl/our-parts/White/thigh_right.stl
61.0 x 47.7 x 28.0
