qilinxiaoxiang/cmu-microduck/1-printing/stl/our-parts/Yellow/jaw_frame.stl

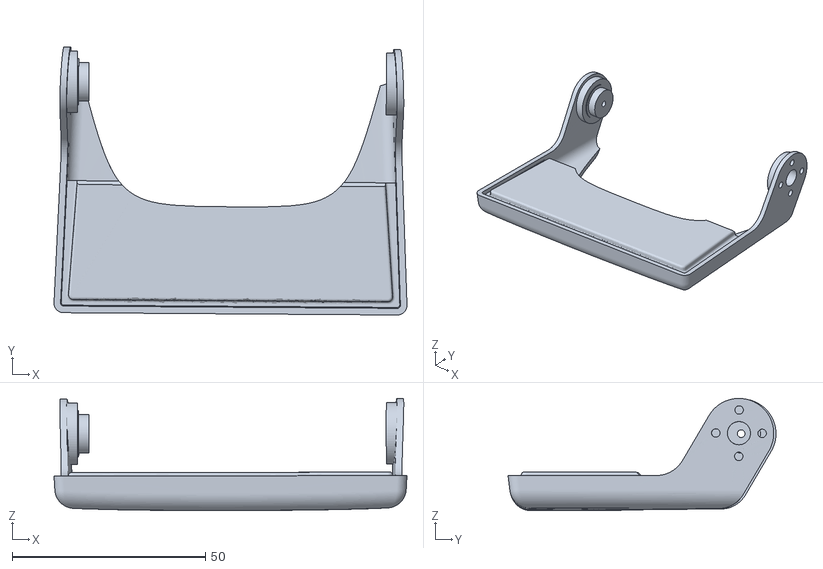
[picture p34: CAD file, 2026-10-24]
1-printing/stl/our-parts/Yellow/jaw_frame.stl
91.4 x 69.4 x 29.0
