qilinxiaoxiang/cmu-microduck/1-printing/stl/our-parts/Black/neck_ring_shim_2mm.stl

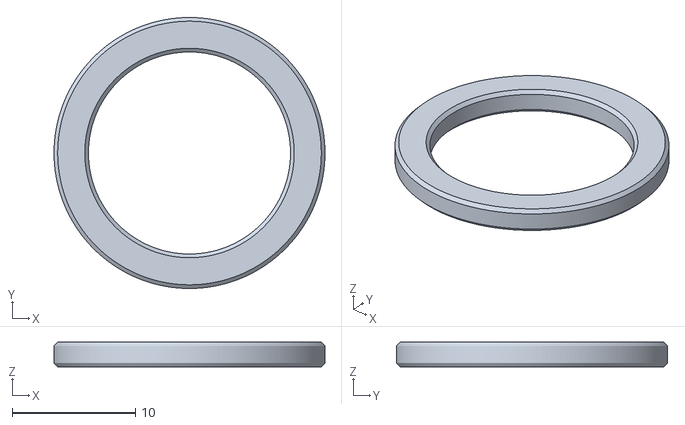
[picture p35: CAD file, 2026-10-24]
1-printing/stl/our-parts/Black/neck_ring_shim_2mm.stl
22.0 x 22.0 x 2.00
