qilinxiaoxiang/cmu-microduck/1-printing/stl/our-parts/White/shell_right_v20.stl

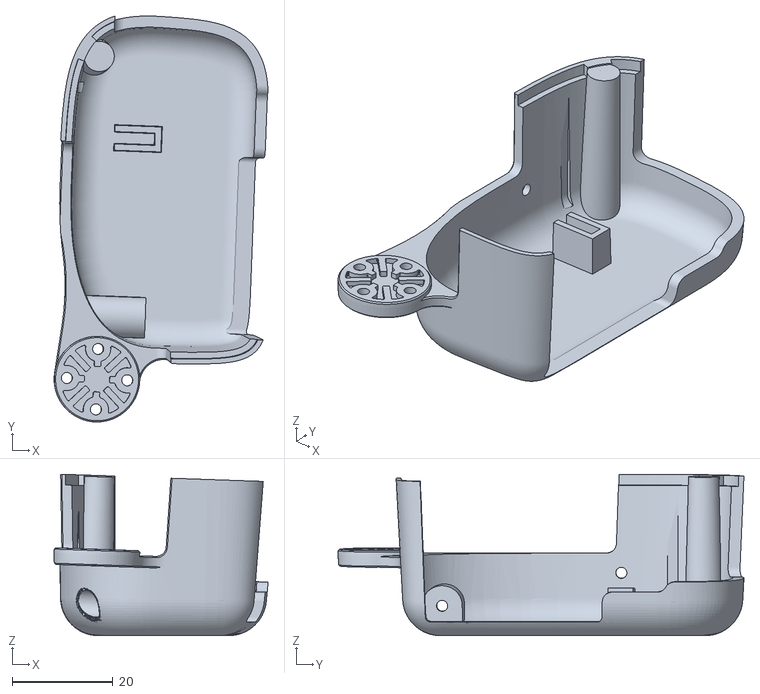
[picture p36: CAD file, 2026-10-24]
1-printing/stl/our-parts/White/shell_right_v20.stl
42.4 x 80.5 x 32.0
