qilinxiaoxiang/cmu-microduck/1-printing/stl/our-parts/Black/neck_pitch_integrated_1mm_seats.stl

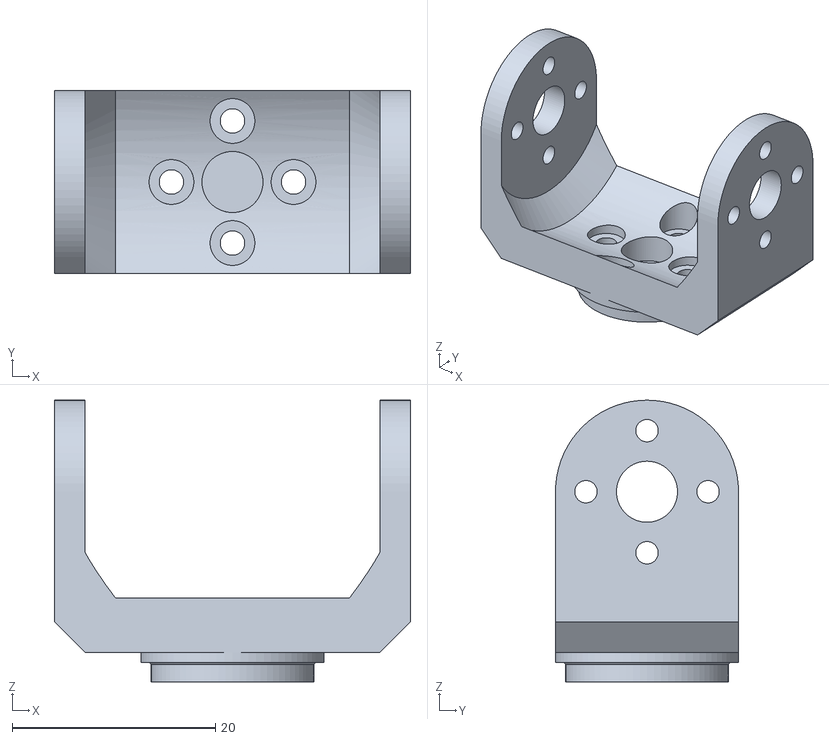
[picture p37: CAD file, 2026-10-24]
1-printing/stl/our-parts/Black/neck_pitch_integrated_1mm_seats.stl
35.0 x 18.0 x 27.7
