qilinxiaoxiang/cmu-microduck/1-printing/stl/our-parts/Orange/rear_lid.stl

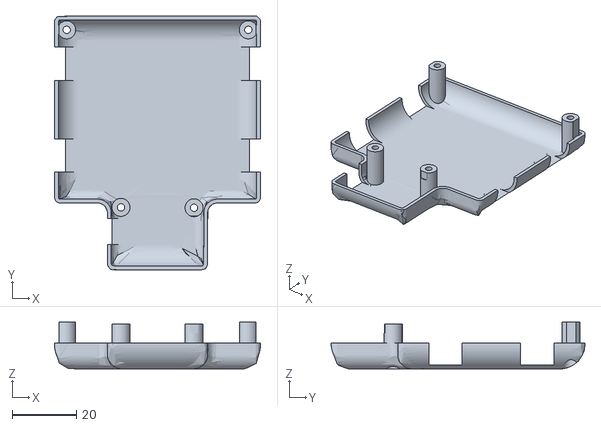
[picture p38: CAD file, 2026-10-24]
1-printing/stl/our-parts/Orange/rear_lid.stl
64.1 x 79.0 x 14.5
