qilinxiaoxiang/cmu-microduck/1-printing/stl/our-parts/White/shell_left_v20.stl

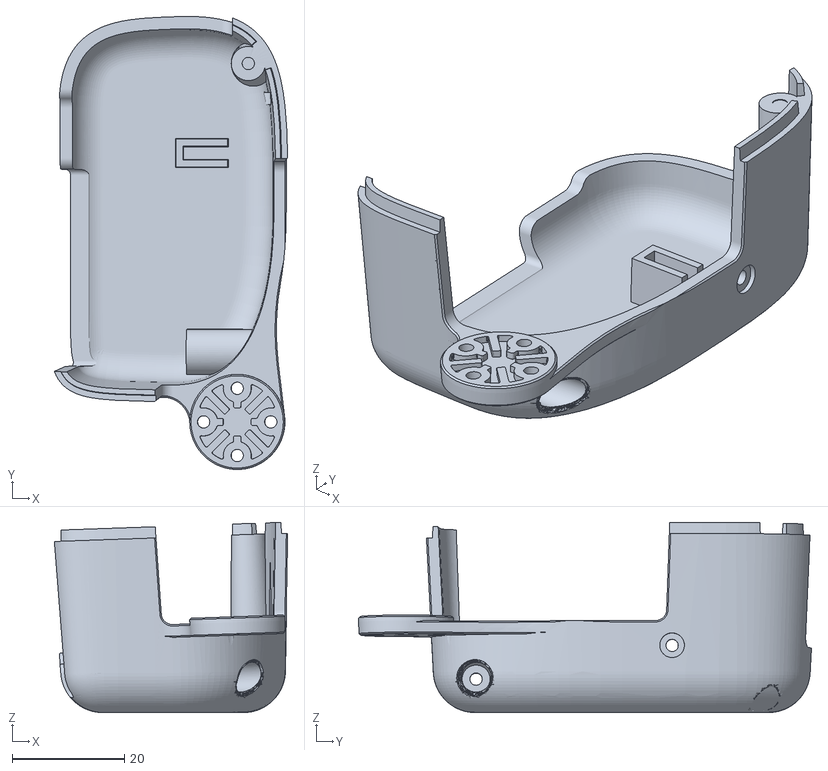
[picture p39: CAD file, 2026-10-24]
1-printing/stl/our-parts/White/shell_left_v20.stl
41.7 x 80.9 x 34.0
