qilinxiaoxiang/cmu-microduck/1-printing/stl/community/community-38.stl

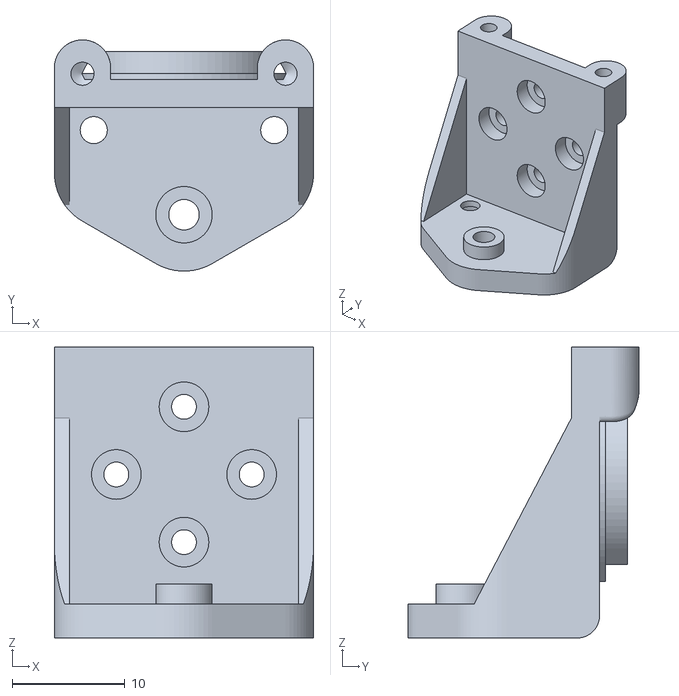
[picture p40: CAD file, 2026-10-24]
1-printing/stl/community/community-38.stl
23.0 x 20.5 x 25.8
