qilinxiaoxiang/cmu-microduck/1-printing/stl/our-parts/Black/ankle_sleeve_left.stl

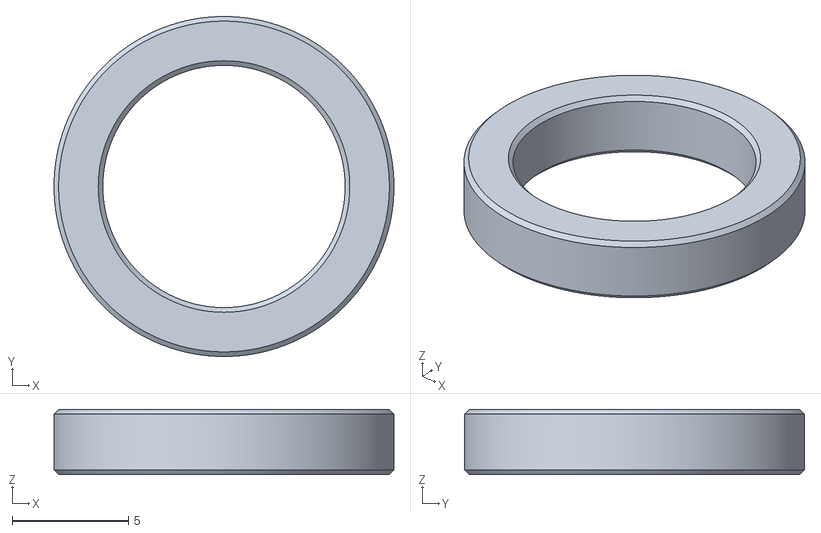
[picture p41: CAD file, 2026-10-24]
1-printing/stl/our-parts/Black/ankle_sleeve_left.stl
14.6 x 14.6 x 2.80
