qilinxiaoxiang/cmu-microduck/1-printing/stl/our-parts/Orange/head_cap.stl

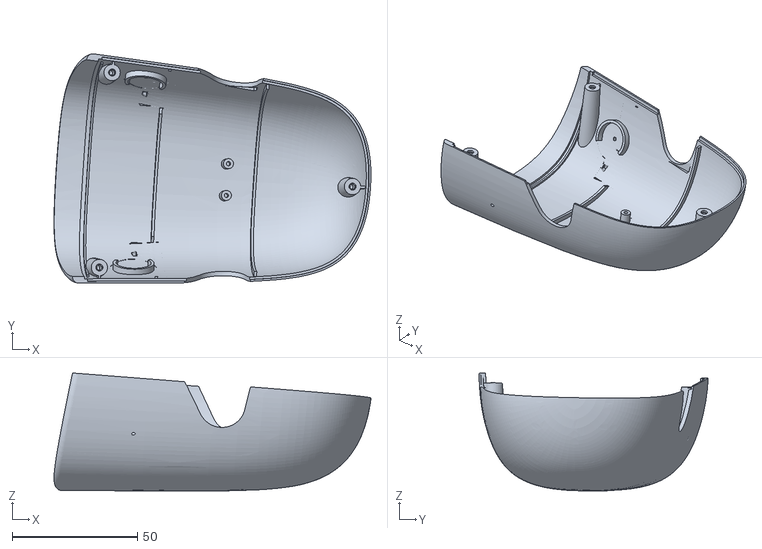
[picture p42: CAD file, 2026-10-24]
1-printing/stl/our-parts/Orange/head_cap.stl
126.5 x 91.6 x 47.1
