qilinxiaoxiang/cmu-microduck/1-printing/stl/our-parts/Black/neck_pitch_ring.stl

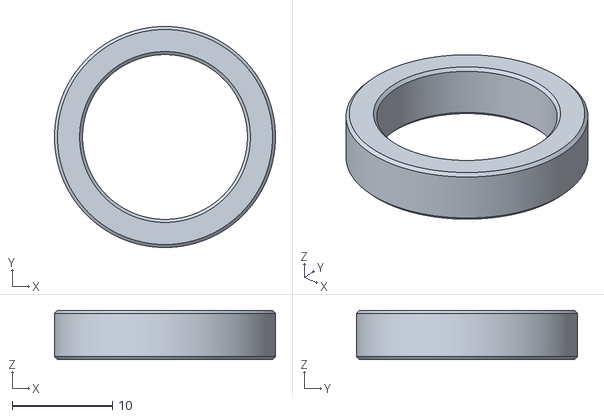
[picture p43: CAD file, 2026-10-24]
1-printing/stl/our-parts/Black/neck_pitch_ring.stl
22.0 x 22.0 x 4.90
