qilinxiaoxiang/cmu-microduck/1-printing/stl/our-parts/Orange/ankle_inner_right.stl

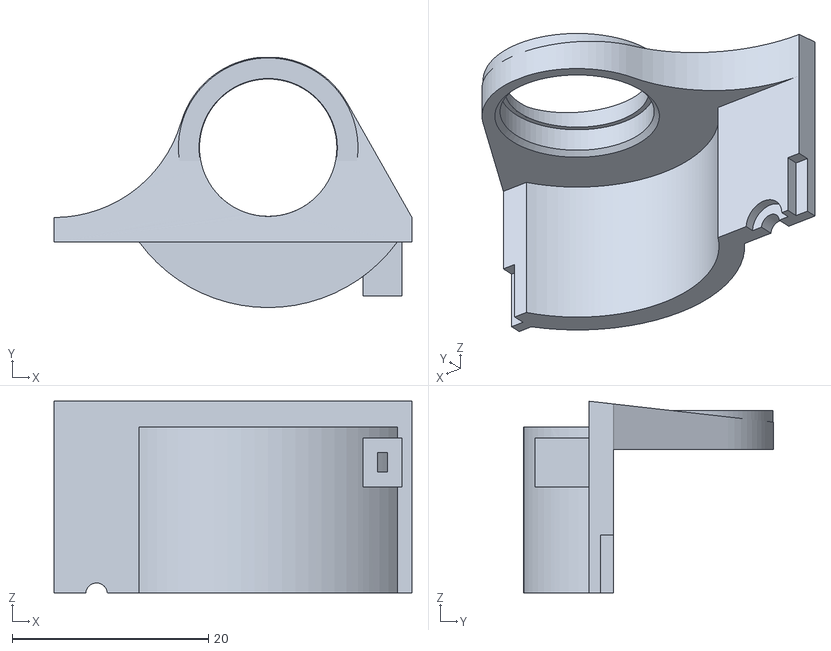
[picture p44: CAD file, 2026-10-24]
1-printing/stl/our-parts/Orange/ankle_inner_right.stl
36.5 x 25.5 x 19.5
