qilinxiaoxiang/cmu-microduck/1-printing/stl/our-parts/Black/lower_right.stl

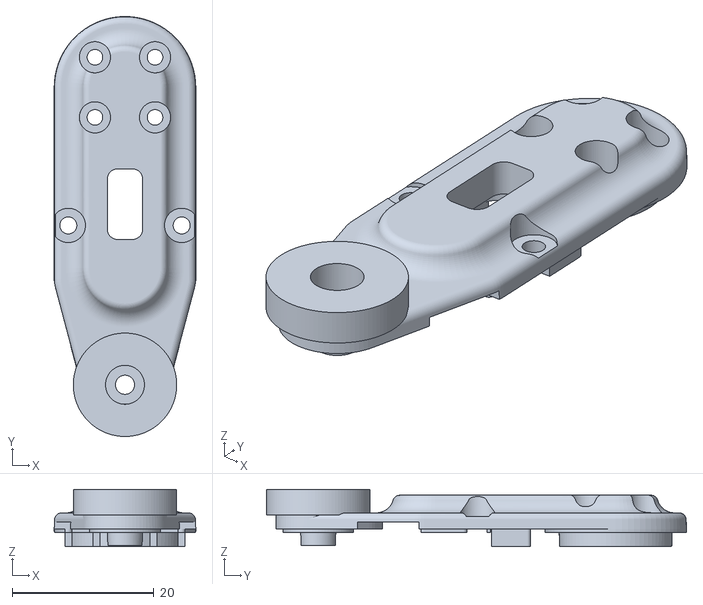
[picture p45: CAD file, 2026-10-24]
1-printing/stl/our-parts/Black/lower_right.stl
20.0 x 59.3 x 8.05
