qilinxiaoxiang/cmu-microduck/1-printing/stl/community/community-57.stl

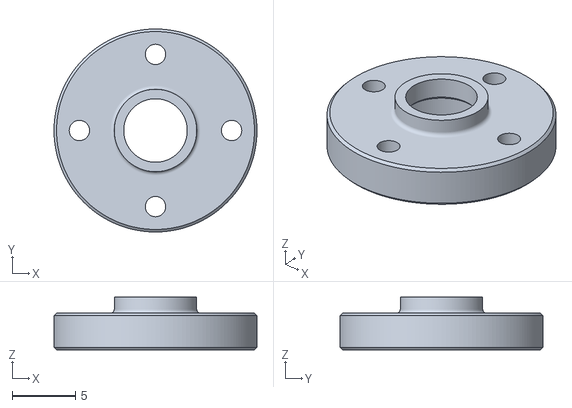
[picture p46: CAD file, 2026-10-24]
1-printing/stl/community/community-57.stl
16.0 x 16.0 x 4.15
