qilinxiaoxiang/cmu-microduck/1-printing/stl/our-parts/Black/neck_ring_shim_1mm.stl

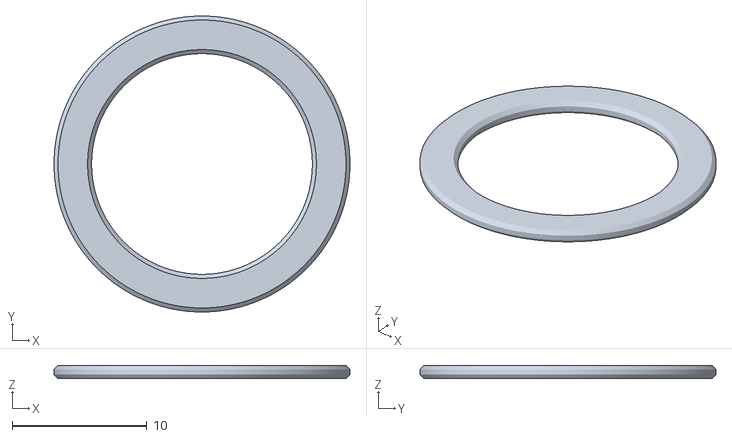
[picture p47: CAD file, 2026-10-24]
1-printing/stl/our-parts/Black/neck_ring_shim_1mm.stl
22.0 x 22.0 x 1.00
