qilinxiaoxiang/cmu-microduck/1-printing/stl/our-parts/Orange/clip_cap_a7z.stl

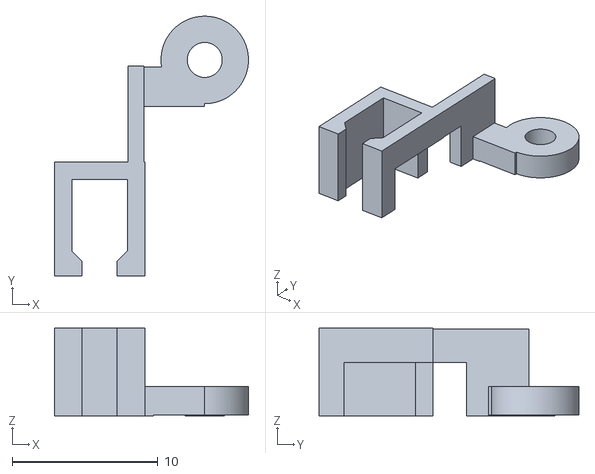
[picture p48: CAD file, 2026-10-24]
1-printing/stl/our-parts/Orange/clip_cap_a7z.stl
13.3 x 17.8 x 6.00
