qilinxiaoxiang/cmu-microduck/1-printing/stl/our-parts/Orange/rear_pack.stl

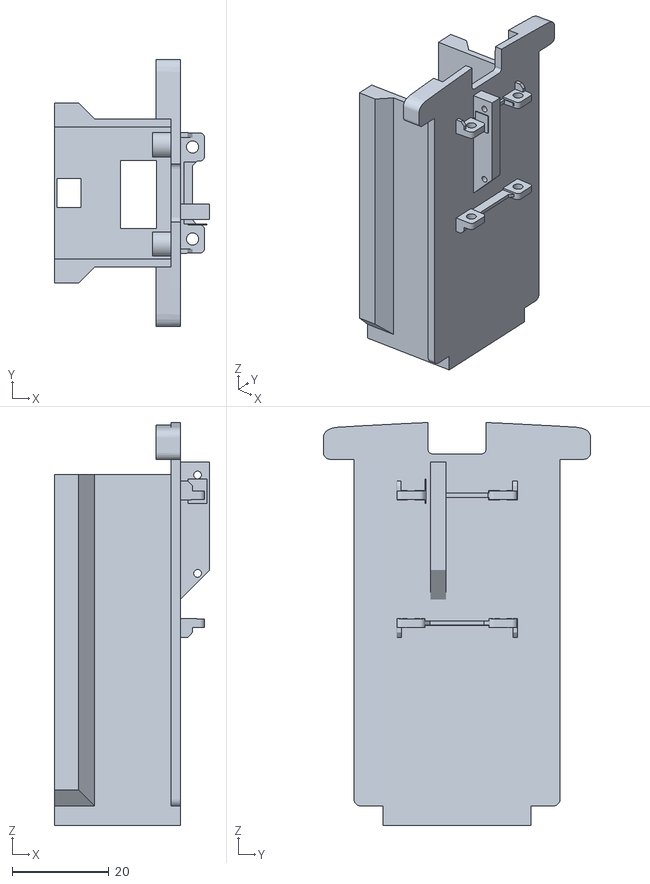
[picture p49: CAD file, 2026-10-24]
1-printing/stl/our-parts/Orange/rear_pack.stl
32.0 x 55.2 x 83.2
