qilinxiaoxiang/cmu-microduck/1-printing/stl/our-parts/Orange/clip_bracket_v19.stl

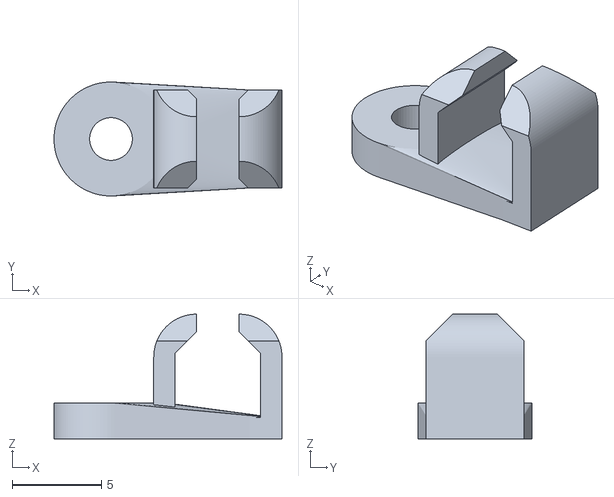
[picture p50: CAD file, 2026-10-24]
1-printing/stl/our-parts/Orange/clip_bracket_v19.stl
12.8 x 6.40 x 7.00
