qilinxiaoxiang/cmu-microduck/1-printing/stl/community/community-16.stl

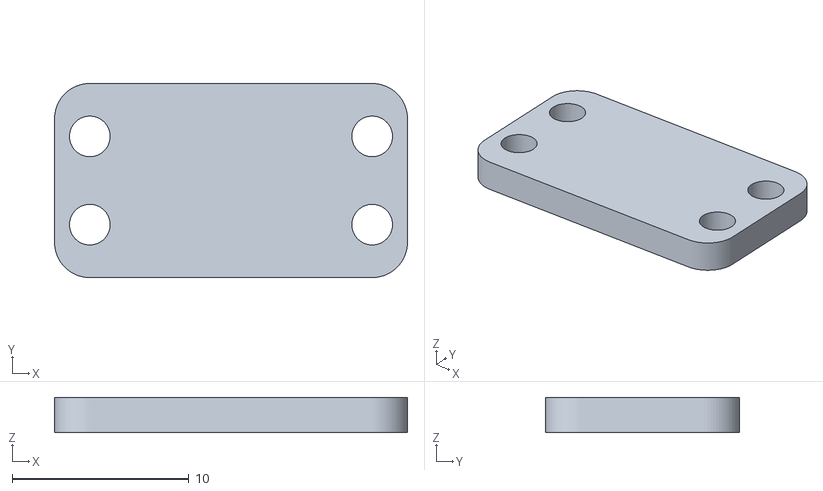
[picture p51: CAD file, 2026-10-24]
1-printing/stl/community/community-16.stl
20.0 x 11.0 x 2.00
