qilinxiaoxiang/cmu-microduck/1-printing/stl/our-parts/Orange/clip_head_v19.stl

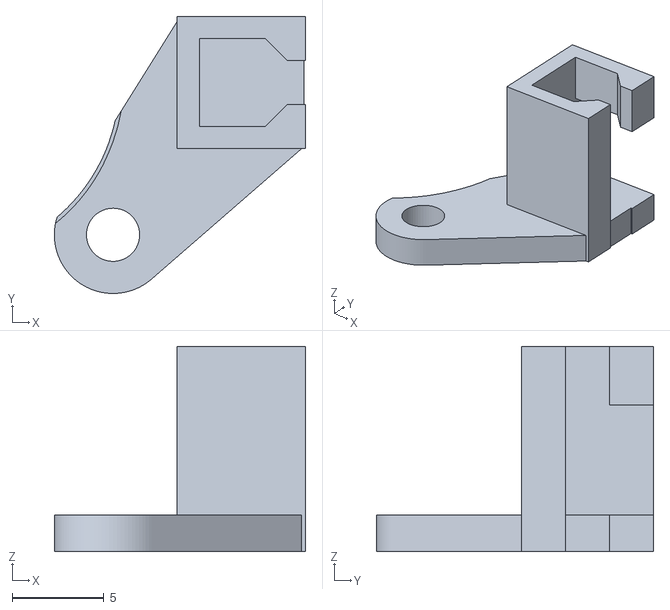
[picture p52: CAD file, 2026-10-24]
1-printing/stl/our-parts/Orange/clip_head_v19.stl
13.7 x 15.1 x 11.2
