qilinxiaoxiang/cmu-microduck/1-printing/stl/our-parts/Orange/rear_frame.stl

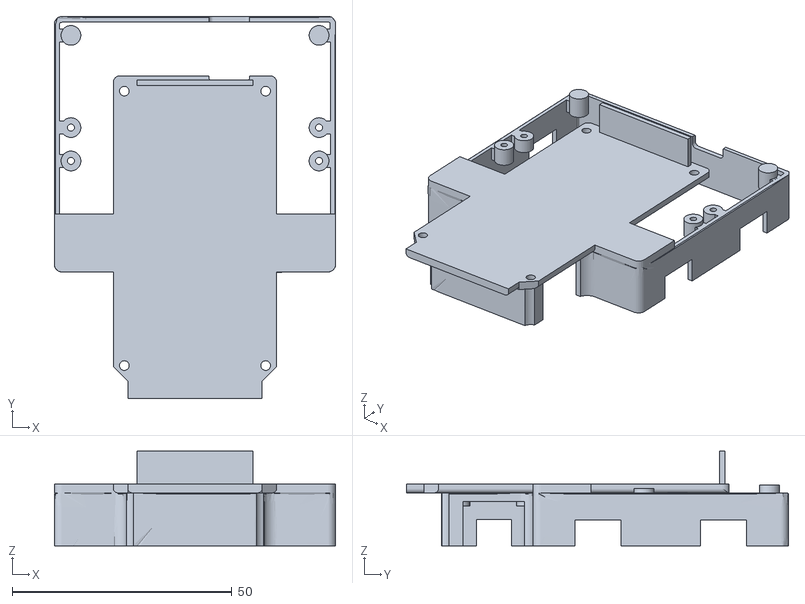
[picture p53: CAD file, 2026-10-24]
1-printing/stl/our-parts/Orange/rear_frame.stl
64.1 x 87.0 x 21.6
