qilinxiaoxiang/cmu-microduck/1-printing/stl/community/community-14.stl

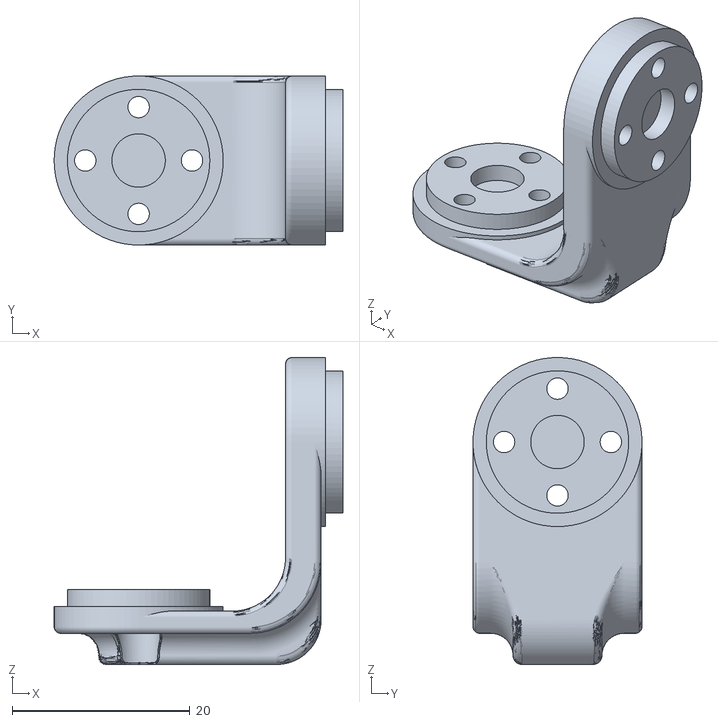
[picture p54: CAD file, 2026-10-24]
1-printing/stl/community/community-14.stl
32.5 x 19.0 x 34.5
