qilinxiaoxiang/cmu-microduck/1-printing/stl/community/community-20.stl

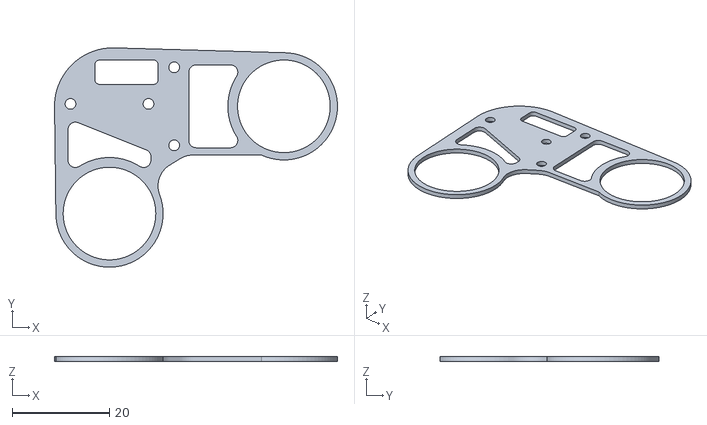
[picture p55: CAD file, 2026-10-24]
1-printing/stl/community/community-20.stl
58.1 x 45.0 x 0.998
