qilinxiaoxiang/cmu-microduck/1-printing/stl/community/community-34.stl

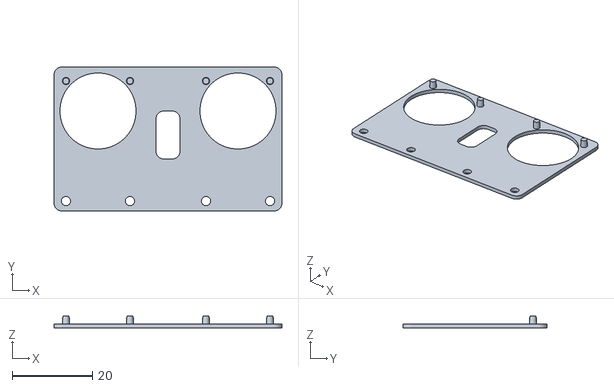
[picture p56: CAD file, 2026-10-24]
1-printing/stl/community/community-34.stl
57.0 x 36.0 x 3.00
