qilinxiaoxiang/cmu-microduck/1-printing/stl/community/community-50.stl

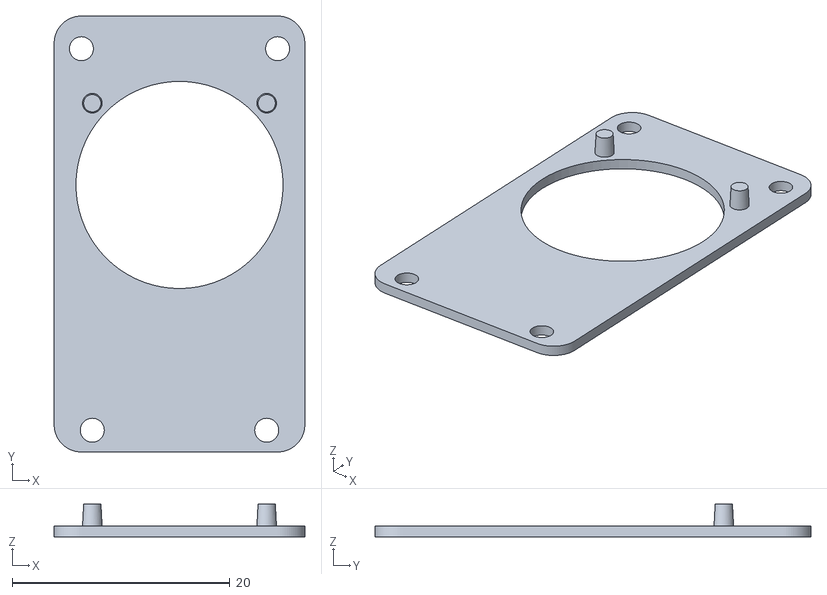
[picture p57: CAD file, 2026-10-24]
1-printing/stl/community/community-50.stl
23.0 x 40.0 x 3.00
