qilinxiaoxiang/cmu-microduck/1-printing/stl/community/community-70.stl

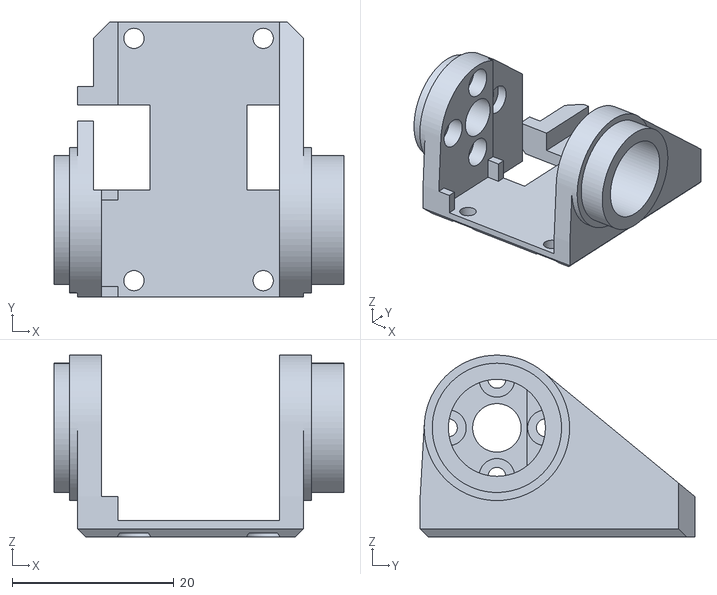
[picture p58: CAD file, 2026-10-24]
1-printing/stl/community/community-70.stl
35.9 x 34.0 x 22.5
