qilinxiaoxiang/cmu-microduck/(list of files, cad)

Other CAD files:
1-printing/stl/community/community-91.stl
1-printing/stl/our-parts/Yellow/foot_left_slipfit.stl
1-printing/stl/community/community-94.stl
1-printing/stl/our-parts/White/thigh_left.stl
1-printing/stl/community/community-95.stl
1-printing/stl/community/community-84.stl
1-printing/stl/our-parts/Orange/ankle_outer_right.stl
1-printing/stl/community/community-82.stl
1-printing/stl/community/community-77.stl
1-printing/stl/community/community-59.stl
1-printing/stl/community/community-96.stl
1-printing/stl/our-parts/Orange/ankle_inner_left.stl
1-printing/stl/community/community-85.stl
1-printing/stl/community/community-87.stl
1-printing/stl/community/community-98.stl
1-printing/stl/community/community-79.stl
1-printing/stl/community/community-89.stl
1-printing/stl/community/community-92.stl
1-printing/stl/community/community-78.stl
1-printing/stl/community/community-83.stl
1-printing/stl/community/community-22.stl
1-printing/stl/community/community-81.stl
1-printing/stl/community/community-99.stl
1-printing/stl/community/community-93.stl
1-printing/stl/community/community-60.stl
1-printing/stl/community/community-53.stl
1-printing/stl/community/community-100.stl
1-printing/stl/community/community-55.stl
1-printing/stl/community/community-103.stl
1-printing/stl/community/community-97.stl
1-printing/stl/community/community-101.stl
1-printing/stl/community/community-56.stl
1-printing/stl/community/community-36.stl
