qilinxiaoxiang/cmu-microduck/4-power/images/openrb-wiring.png

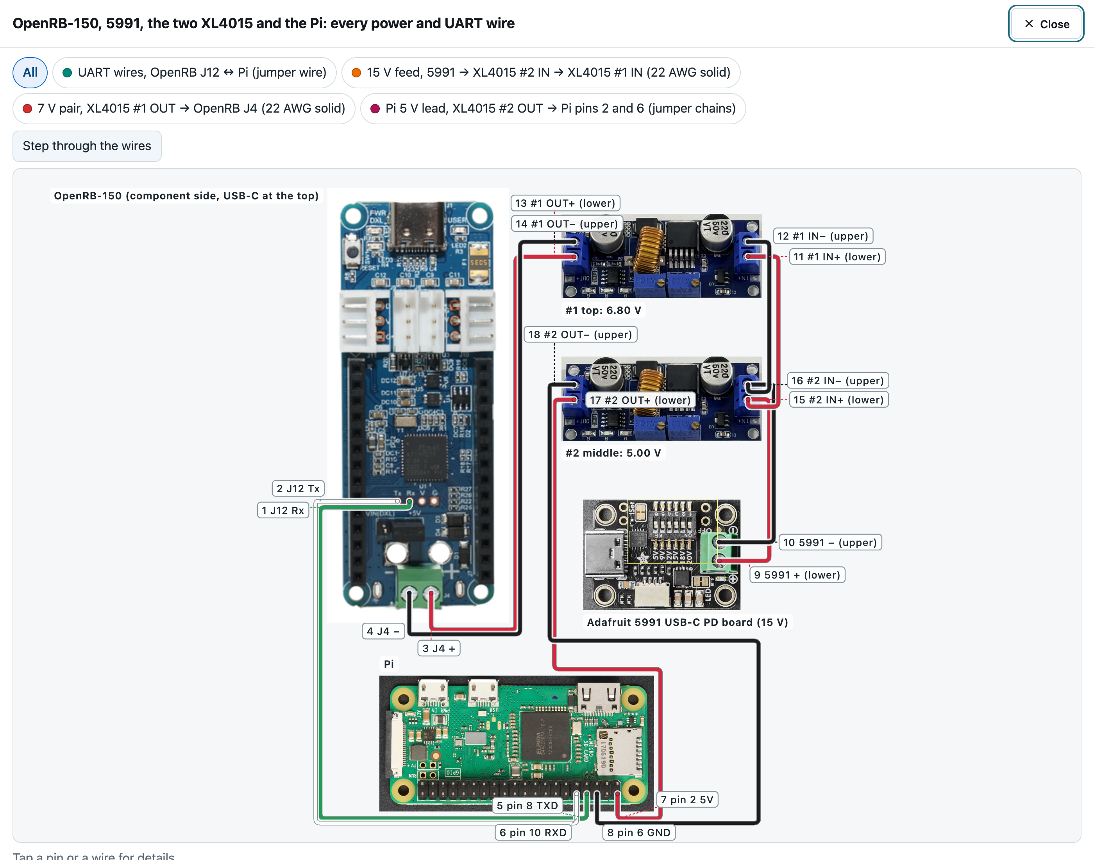
4-power/images/openrb-wiring.png
