qilinxiaoxiang/cmu-microduck/(commit log)

2026-10-24 CMU MicroDuck foundation (2026-10-23): everything needed to reproduce the robot as it stood that day
    Printing (34 of our STLs plus AI-FanGe's 44 community files, derived from the release records by
    scripts/collect_printed_parts.py; sliced plates listed in PLATES.md as release assets), servos and OpenRB
    (openrb_dual_host firmware, ID/role/chain, setup scripts, flash procedure), brain and senses (Radxa Cubie A7Z
    pin map, image and overlays, IMU, speaker, touch board, camera, thermal limit), power (USB-C PD route in use,
    2S battery route designed), assembly and bring-up pages (self-contained HTML, 34 page renders verified at
    1280 and 390 px), runtime (walk_wired closure, policy fetch script wit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
    [ankle_inner_left.stl, ankle_inner_right.stl, ankle_outer_left.stl, ankle_outer_right.stl, ankle_sleeve_left.stl, battery_backpack_cap-V1.20-print.stl, battery_backpack_cap.stl, battery_backpack_frame-V1.31-print.stl]
2026-10-24 README: link the GitHub Pages guide and the plate release
2026-10-24 Name the club by its proper name, CMU RoboClub; 15-DoF, not 15-servo, for the robot
